rhetoricguitar3aiEngineer/MotoNode/eclipse-lamp/electronics/hub/drc-report.txt

** Drc report for eclipse-hub.kicad_pcb **
** Created on 2026-10-11T15:10:16+0000 **
** Report includes: Errors, Warnings **

** Found 0 DRC violations **

** Found 0 unconnected pads **

** Found 0 Footprint errors **

** End of Report **
