rhetoricguitar3aiEngineer/MotoNode/eclipse-lamp/electronics/core/drc-report.txt

** Drc report for eclipse-core.kicad_pcb **
** Created on 2026-10-10T22:11:24+0000 **
** Report includes: Errors, Warnings **

** Found 0 DRC violations **

** Found 0 unconnected pads **

** Found 0 Footprint errors **

** End of Report **
