rhetoricguitar3aiEngineer/MotoNode/eclipse-lamp/electronics/sprig/drc-report.txt

** Drc report for eclipse-sprig.kicad_pcb **
** Created on 2026-10-10T22:09:48+0000 **
** Report includes: Errors, Warnings **

** Found 0 DRC violations **

** Found 0 unconnected pads **

** Found 0 Footprint errors **

** End of Report **
