rhetoricguitar3aiEngineer/MotoNode/eclipse-lamp/renders/pcb_core_bottom.png

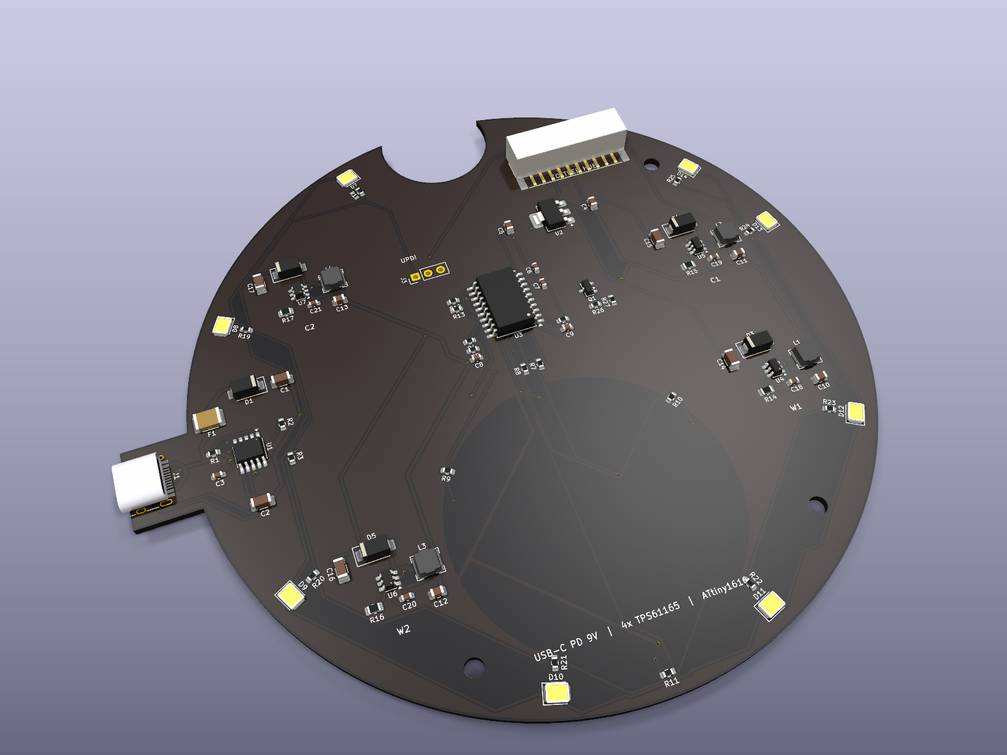
eclipse-lamp/renders/pcb_core_bottom.png
