rhetoricguitar3aiEngineer/MotoNode/eclipse-lamp/renders/pcb_core_top.png

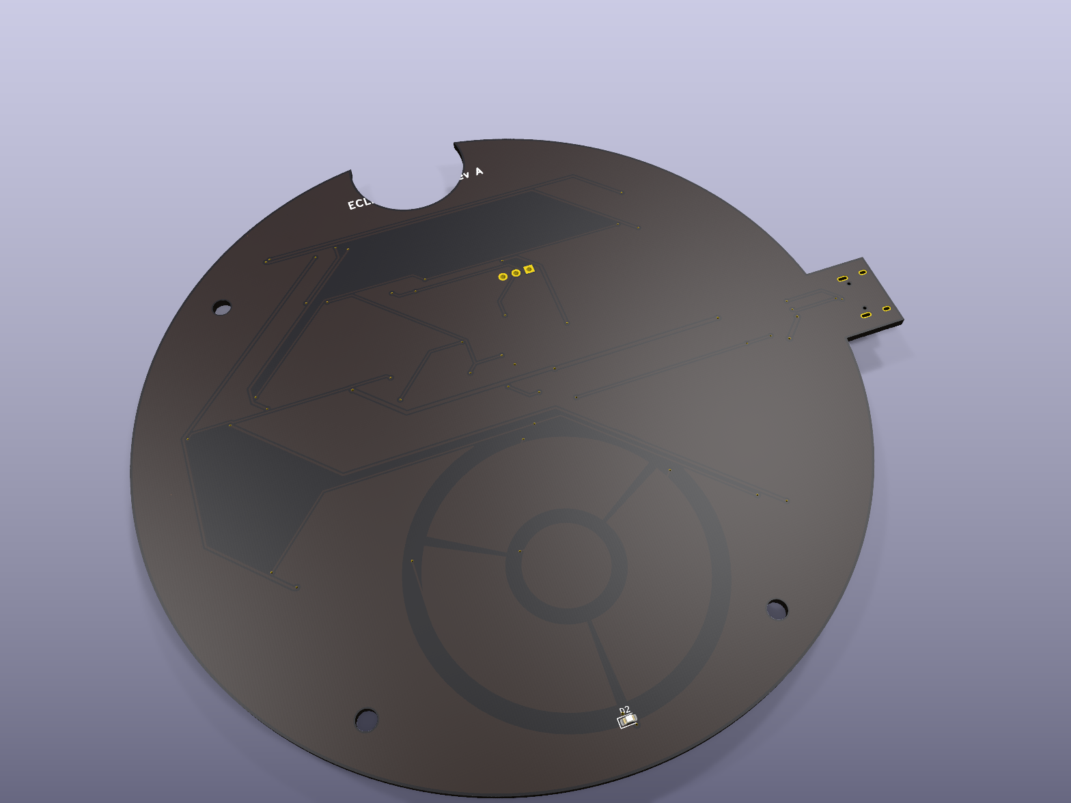
eclipse-lamp/renders/pcb_core_top.png
