rhetoricguitar3aiEngineer/MotoNode/eclipse-lamp/bom/eclipse_bom.csv

Section | Refs | Qty | Value | Description | Manufacturer | MPN | LCSC | Footprint | Unit USD | Ext USD | Note
Core board (base) | C1,C2 | 2 | 22uF 25V | Input bulk | Murata | GRM31CR61E226KE15L |  | C_1206_3216Metric | 0.06 | 0.12
Core board (base) | C3,C7 | 2 | 1uF | CH224K VDD decoupling,MCU decoupling | Murata | GRM188R61E105KA12D |  | C_0603_1608Metric | 0.006 | 0.012
Core board (base) | C4 | 1 | 10uF | LDO input | Samsung | CL21A106KAYNNNE |  | C_0805_2012Metric | 0.02 | 0.02
Core board (base) | C5 | 1 | 22uF | LDO output | Samsung | CL21A226MAQNNNE |  | C_0805_2012Metric | 0.02 | 0.02
Core board (base) | C6,C8,C9 | 3 | 100nF | MCU decoupling | Murata | GRM188R71H104KA93D |  | C_0603_1608Metric | 0.004 | 0.012
Core board (base) | C10,C11,C12,C13 | 4 | 10uF 25V | Boost input | Samsung | CL21A106KAYNNNE |  | C_0805_2012Metric | 0.02 | 0.08
Core board (base) | C14,C15,C16,C17 | 4 | 1uF 50V | Boost output | Murata | GRM31MR71H105KA88L |  | C_1206_3216Metric | 0.04 | 0.16
Core board (base) | C18,C19,C20,C21 | 4 | 220nF | Loop compensation | Murata | GRM188R71E224KA88D |  | C_0603_1608Metric | 0.006 | 0.024
Core board (base) | D1 | 1 | SMAJ15CA | TVS 15 V standoff, bidirectional, 400 W | Littelfuse | SMAJ15CA |  | D_SMA | 0.05 | 0.05
Core board (base) | D2 | 1 | WHITE | 0603 white - glow under touch glass | Lite-On | LTW-C191TS5 |  | LED_0603_1608Metric | 0.03 | 0.03
Core board (base) | D3,D4,D5,D6 | 4 | MBRA160 | Schottky 60 V 1 A | onsemi | MBRA160T3G |  | D_SMA | 0.06 | 0.24
Core board (base) | D7,D8,D9,D10,D11,D12,D13,D14 | 8 | 2700K | 2835 warm white, fires down into the white-lined base cavity | Samsung | LM281B+ 2700K |  | LED_PLCC_2835 | 0.03 | 0.24
Core board (base) | F1 | 1 | 1.5A | PTC resettable fuse 1.5 A hold, 24 V | Bourns | MF-MSMF150/24X-2 |  | Fuse_1812_4532Metric | 0.1 | 0.1
Core board (base) | J1 | 1 | USB-C 16P | USB Type-C receptacle, 16P, SMD + THT shell | Korean Hroparts | TYPE-C-31-M-12 | C165948 | USB_C_Receptacle_HRO_TYPE-C-31-M-12 | 0.12 | 0.12
Core board (base) | J2 | 1 | TO HUB | PH 2.0 mm 10-pin side-entry SMD | JST | S10B-PH-SM4-TB |  | JST_PH_S10B-PH-SM4-TB_1x10-1MP_P2.00mm_Horizontal | 0.25 | 0.25
Core board (base) | J3 | 1 | UPDI | UPDI programming header | - | DNP (pogo pads) |  | PinHeader_1x03_P2.54mm_Vertical | 0.0 | 0.0 | DNP
Core board (base) | L1,L2,L3,L4 | 4 | 10uH | 10 uH shielded, Isat 1.6 A | Bourns | SRN4018-100M |  | L_Bourns-SRN4018 | 0.12 | 0.48
Core board (base) | Q1 | 1 | AO3400A | N-MOSFET 30 V, low-side glow switch | Alpha & Omega | AO3400A |  | SOT-23 | 0.03 | 0.03
Core board (base) | R1,R7,R8,R9,R10 | 5 | 1k | CH224K VDD feed,PTC series resistor | Yageo | RC0603FR-071KL |  | R_0603_1608Metric | 0.002 | 0.01
Core board (base) | R2 | 1 | 6.8k | CFG1: 6.8k = 9 V request | Yageo | RC0603FR-076K8L |  | R_0603_1608Metric | 0.002 | 0.002
Core board (base) | R3,R6 | 2 | 10k | NTC pull-up,PG pull-up | Yageo | RC0603FR-0710KL |  | R_0603_1608Metric | 0.002 | 0.004
Core board (base) | R4,R12,R13,R27 | 4 | 100k | Gate pull-down,Keeps drivers off during reset,VIN sense divider top | Yageo | RC0603FR-07100KL |  | R_0603_1608Metric | 0.002 | 0.008
Core board (base) | R5 | 1 | 15k | VIN sense divider bottom | Yageo | RC0603FR-0715KL |  | R_0603_1608Metric | 0.002 | 0.002
Core board (base) | R11 | 1 | 470 | Status LED | Yageo | RC0603FR-07470RL |  | R_0603_1608Metric | 0.002 | 0.002
Core board (base) | R14,R15,R16,R17 | 4 | 2.0 | Sense: 200 mV / 2.0 R = 100 mA | Yageo | RC0805FR-072RL |  | R_0805_2012Metric | 0.004 | 0.016
Core board (base) | R18,R19,R20,R21,R22,R23,R24,R25,R26 | 9 | 100 | Gate series,Glow LED ballast, ~5 mA | Yageo | RC0603FR-07100RL |  | R_0603_1608Metric | 0.002 | 0.018
Core board (base) | U1 | 1 | CH224K | USB PD/QC sink trigger, resistor-configured output voltage | WCH | CH224K | C970725 | SSOP-10-1EP_3.9x4.9mm_P1mm_EP2.1x3.3mm | 0.35 | 0.35
Core board (base) | U2 | 1 | AMS1117-3.3 | LDO 3.3 V 1 A | Advanced Monolithic Systems | AMS1117-3.3 | C6186 | SOT-223-3_TabPin2 | 0.05 | 0.05
Core board (base) | U3 | 1 | ATtiny1616-S | AVR 16 kB, PTC touch, 20 MHz | Microchip | ATTINY1616-SNR |  | SOIC-20W_7.5x12.8mm_P1.27mm | 0.85 | 0.85
Core board (base) | U4,U5,U6,U7 | 4 | TPS61165 | 38 V boost white-LED driver, 1.2 A switch | Texas Instruments | TPS61165DBVR |  | SOT-23-6 | 0.55 | 2.2
Hub board (in the trunk fork) | D1,D2,D3,D4,D9,D10,D11,D12 | 8 | 2700K | Fibre-bundle light source (top), 25 mA,Trunk light-guide source (bottom), 25 mA | Samsung | LM281B+ 2700K |  | LED_PLCC_2835 | 0.03 | 0.24
Hub board (in the trunk fork) | D5,D6,D7,D8,D13,D14,D15,D16 | 8 | 6500K | Fibre-bundle light source (top), 25 mA,Trunk light-guide source (bottom), 25 mA | Samsung | LM281B+ 6500K |  | LED_PLCC_2835 | 0.03 | 0.24
Hub board (in the trunk fork) | TH1 | 1 | 10k B3380 | NTC 10k 1% B=3380, 0603 | Murata | NCP18XH103F03RB |  | R_0603_1608Metric | 0.03 | 0.03
LED sprigs (x40 per lamp) | D1,D2,D3,D4,D5,D6,D7,D8,D9,D10,D11,D12,D13,D14,D15,D16,D17,D18,D19,D20 on 20 sprigs | 400 | LEAF 2700 K | Leaf LED 0402 white 2700 K, If 5 mA | Inolux / Lite-On (select bin) | 0402 white LED 2700 K (select bin) |  | LED_0402_1005Metric | 0.012 | 4.8 | same Vf bin per sprig
LED sprigs (x40 per lamp) | D1,D2,D3,D4,D5,D6,D7,D8,D9,D10,D11,D12,D13,D14,D15,D16,D17,D18,D19,D20 on 20 sprigs | 400 | LEAF 6500 K | Leaf LED 0402 white 6500 K, If 5 mA | Inolux / Lite-On (select bin) | 0402 white LED 6500 K (select bin) |  | LED_0402_1005Metric | 0.012 | 4.8 | same Vf bin per sprig
Bare PCBs | PCB1 | 1 |  | Core PCB, D124 + USB tab, 2L 1.6 mm FR4, 1 oz, matte black, ENIG | PCB fab (e.g. JLCPCB) | eclipse-core |  |  | 1.2 | 1.2 | gerbers via KiCad
Bare PCBs | PCB2 | 1 |  | Hub light-engine PCB, D56 with D5 hole, 2L 1.0 mm FR4, white mask, ENIG, 2-side SMT | PCB fab (e.g. JLCPCB) | eclipse-hub |  |  | 0.6 | 0.6 | gerbers via KiCad
Bare PCBs | PCB3 | 40 |  | Sprig flex, 2L polyimide 0.11 mm, bronze coverlay, ENIG (panelised) | PCB fab (e.g. JLCPCB) | eclipse-sprig |  |  | 0.22 | 8.8 | gerbers via KiCad
Mechanical | M1 | 1 |  | Base upper shell, D150 x 12 (touch skin + trunk socket) | 6061-T6, CNC turned+milled, bead blast, graphite anodise; cavity white-painted | ECL-M-001 |  |  | 7.5 | 7.5
Mechanical | M2 | 1 |  | Weight / reflector disc, D110 x 6.5 (~0.48 kg) | S235 steel, laser cut, white powder coat | ECL-M-002 |  |  | 1.6 | 1.6
Mechanical | M3 | 1 |  | Root-glow band, D148/D138 x 7 | Light-diffusing PMMA, extruded tube cut + polished | ECL-M-003 |  |  | 0.7 | 0.7
Mechanical | M4 | 1 |  | Plinth, D150 x 3 + 3 posts (~0.42 kg) | S235 steel, laser cut, posts welded, black powder coat | ECL-M-004 |  |  | 2.4 | 2.4
Mechanical | M5 | 1 |  | Foot ring, D146/D122 x 1 | Cork/rubber composite, die cut, PSA backed | ECL-M-005 |  |  | 0.3 | 0.3
Mechanical | M6 | 1 |  | Touch window, D52 x 3 | Soda-lime glass, satin etch top, screen-printed ring | ECL-M-006 |  |  | 1.6 | 1.6
Mechanical | M7 | 1 |  | Trunk shell D77 (root flare, fork swelling that houses the hub), 7 buttress roots, open bark fissures | Lost-wax cast silicon bronze, 2.5 mm wall, 2 halves | ECL-M-007 |  |  | 21.0 | 21.0
Mechanical | M7a | 1 |  | Trunk light-guide tube, ~150 mm, 8 mm wall (harness in the bore) | Light-diffusing PMMA (LED-grade, low haze), cast + polished, white-dot extraction print | ECL-M-016 |  |  | 5.5 | 5.5
Mechanical | M7b | 1 |  | Trunk spigot, D14 x 2 tube, 40 mm (into the base socket) | C260 brass, brazed into the trunk casting | ECL-M-017 |  |  | 0.6 | 0.6
Mechanical | M8 | 1 |  | Leaders + scaffold limbs (wood >= D12): 3 leaders flaring out of the fork, 7 cast pieces | Lost-wax cast silicon bronze, 2 mm wall, brazed to the trunk casting | ECL-M-008 |  |  | 12.0 | 12.0
Mechanical | M9 | 1 |  | Crown wood: 1,167 branches and twigs grown by space colonisation (~29 m), pipe-model taper | 21 x C260 brass tube D4-12 + 1,146 x C260 rod/wire D0.8-4, jig-formed from parts.json, brazed | ECL-M-009 |  |  | 46.0 | 46.0
Mechanical | M9a | 1 |  | End-glow optical fibre, 567 x 0.5 mm, ~0.35 m each, in 4 bundles | PMMA POF, end-glow, black jacket stripped at the tips | ECL-O-001 |  |  | 4.2 | 4.2
Mechanical | M9b | 4 |  | Fibre bundle ferrule (over the hub's top LED pair) | Machined aluminium, polished fibre face, optical gel | ECL-O-002 |  |  | 0.4 | 1.6
Mechanical | M9c | 567 |  | Samara (seed) diffuser, 3.6 x 2.4 x 0.9 mm, dip-moulded on each fibre tip | Diffusing epoxy (TiO2 0.2 %), warm tint | ECL-O-003 |  |  | 0.003 | 1.701
Mechanical | M9d | 1 |  | Foliage: 21,770 cedar-elm leaves (4.6-7 mm) as ~1,170 laser-cut twig sprays | 0.125 mm light-diffusing olive PET film, 2 tones, bonded to the twigs | ECL-O-004 |  |  | 9.0 | 9.0
Mechanical | M10 | 1 |  | Bark finish, whole tree | Brown-grey liver-of-sulphur patina + matte lacquer | ECL-M-010 |  |  | 2.5 | 2.5
Mechanical | M11 | 1 |  | Magnet wire, 80 x 0.15 mm, ~0.4 m each, laid along the wood | Polyurethane-enamelled Cu (solderable), bark-colour | ECL-W-002 |  |  | 0.7 | 0.7
Mechanical | M12 | 1 |  | Trunk harness, 10 x AWG30 PTFE, 260 mm | Hub J1 lands -> core J2 (JST PHR-10 + SPH-002T) | ECL-W-001 |  |  | 0.7 | 0.7
Mechanical | M13 | 1 |  | Hub potting + light-engine optical gel | Black flexible epoxy (back side) + clear silicone gel (LED faces) | ECL-M-013 |  |  | 0.4 | 0.4
Mechanical | F1 | 3 |  | Screw M3 x 6, pan head (core PCB) | A2 stainless | ISO 14583 |  |  | 0.02 | 0.06
Mechanical | F2 | 1 |  | Set screw M4 x 4, cup point (trunk socket) | A2 stainless | ISO 4029 |  |  | 0.02 | 0.02
Mechanical | F3 | 3 |  | Screw M3 x 10, countersunk (plinth posts into shell) | A2 stainless | ISO 10642 |  |  | 0.03 | 0.09
Mechanical | F4 | 2 |  | Screw M2 x 6 (trunk casting halves at the fork) | A2 stainless | ISO 14583 |  |  | 0.02 | 0.04
Mechanical | F5 | 40 |  | Sprig clip: 0.3 mm brass crimp sleeve, sprig root grafted onto its branchlet | C260 brass | ECL-M-014 |  |  | 0.01 | 0.4
