rhetoricguitar3aiEngineer/MotoNode/eclipse-lamp/electronics/core/eclipse-core.step

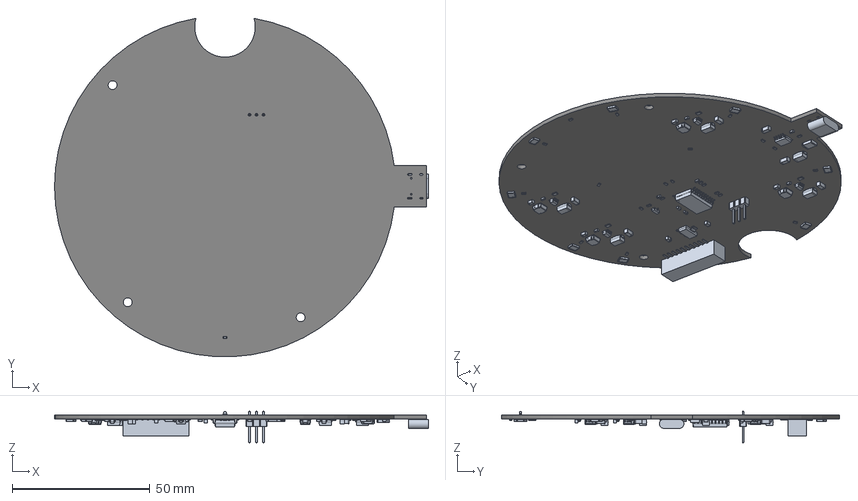
[picture p12: CAD file, 2026-10-11]
eclipse-lamp/electronics/core/eclipse-core.step
136.0 x 123.0 x 11.5 mm
LED_0603_1608Metric
R_0603_1608Metric x 23
housing x 9
phosphor x 8
R_0805_2012Metric x 4
C_1206_3216Metric x 6
L_Bourns-SRN4018 x 4
C_0805_2012Metric x 6
SOT-23-6 x 4
tongue
C_0603_1608Metric x 9
term-1
term1
D_SMA x 5
SOT-23
SOT-223
SSOP-10-1EP_3.9x4.9mm_P1mm_EP2.1x3.3mm
PinHeader_1x03_P2.54mm_Vertical
pins
SOIC-20W_7.5x12.8mm_P1.27mm
eclipse-core_PCB
