rhetoricguitar3aiEngineer/MotoNode/eclipse-lamp/electronics/hub/eclipse-hub.step

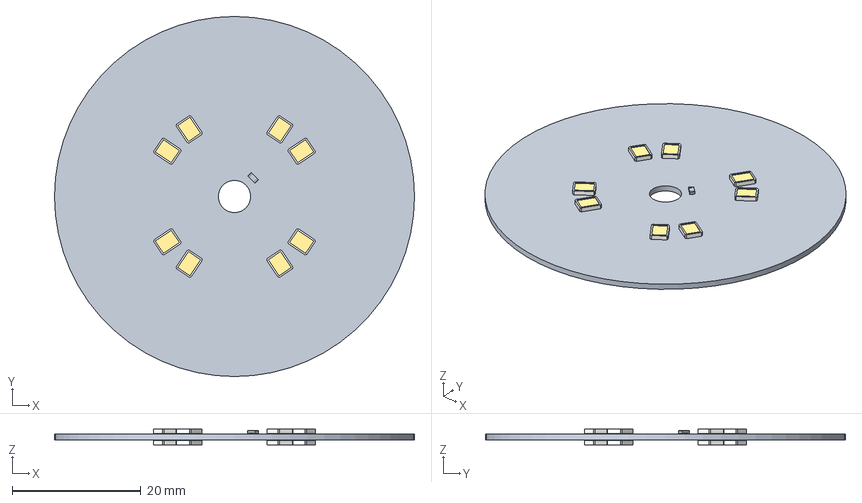
[picture p13: CAD file, 2026-10-11]
eclipse-lamp/electronics/hub/eclipse-hub.step
56.0 x 56.0 x 2.48 mm
housing x 16
phosphor x 16
R_0603_1608Metric
eclipse-hub_PCB
