rhetoricguitar3aiEngineer/MotoNode/eclipse-lamp/electronics/sprig/eclipse-sprig.step

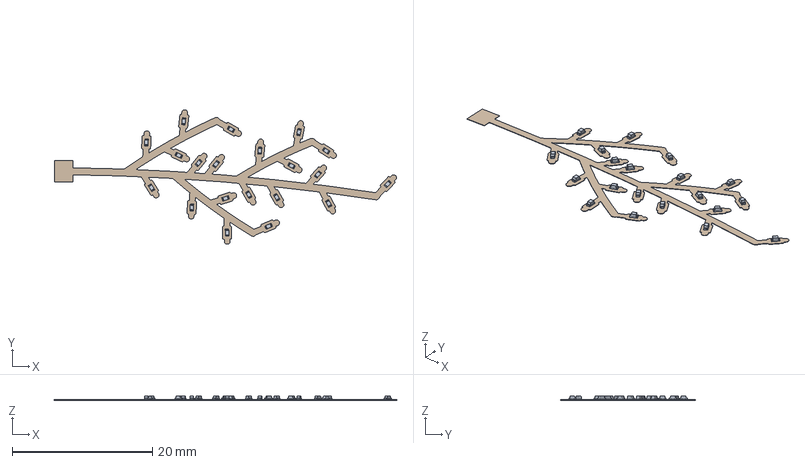
[picture p14: CAD file, 2026-10-11]
eclipse-lamp/electronics/sprig/eclipse-sprig.step
48.8 x 19.2 x 0.622 mm
LED_0402_1005Metric x 20
eclipse-sprig_PCB
