rhetoricguitar3aiEngineer/MotoNode/eclipse-lamp/mechanical/out/base_foot.step

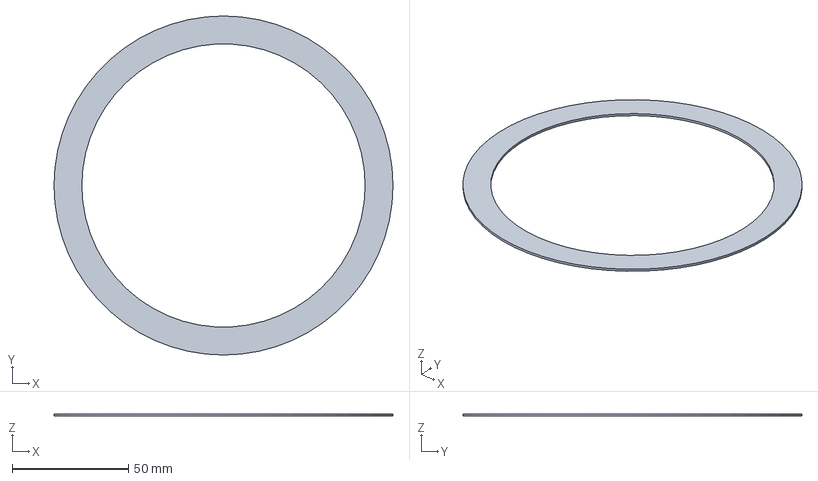
[picture p15: CAD file, 2026-10-16]
eclipse-lamp/mechanical/out/base_foot.step
146.0 x 146.0 x 1.00 mm
