rhetoricguitar3aiEngineer/MotoNode/eclipse-lamp/mechanical/out/base_shell.step

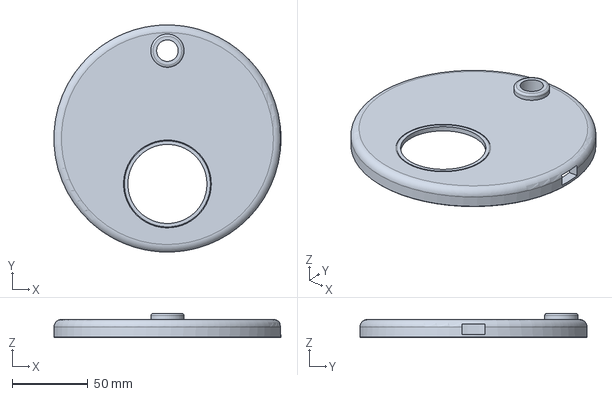
[picture p16: CAD file, 2026-10-16]
eclipse-lamp/mechanical/out/base_shell.step
149.9 x 149.9 x 16.0 mm
