rhetoricguitar3aiEngineer/MotoNode/eclipse-lamp/mechanical/out/trunk.step

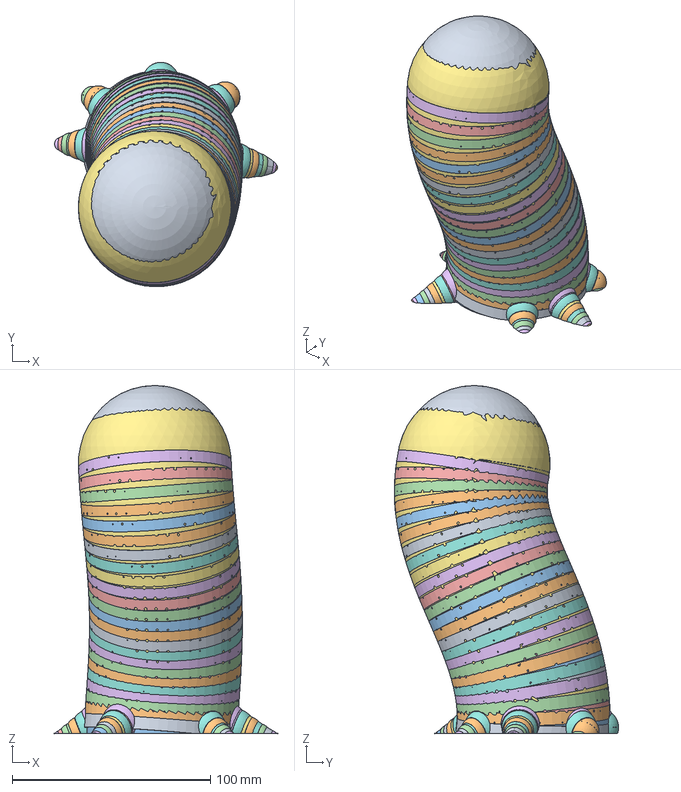
[picture p17: CAD file, 2026-10-16]
eclipse-lamp/mechanical/out/trunk.step
112.4 x 113.0 x 175.3 mm
