rhetoricguitar3aiEngineer/MotoNode/eclipse-lamp/mechanical/out/touch_etch.step

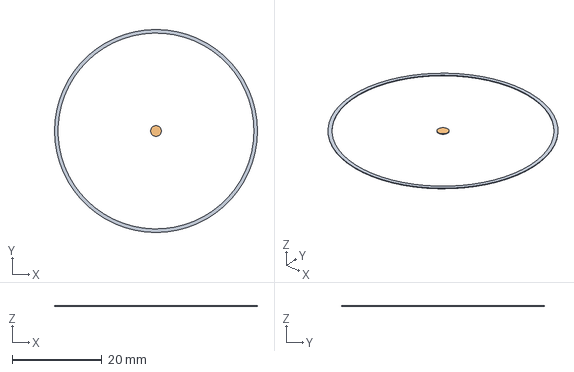
[picture p18: CAD file, 2026-10-16]
eclipse-lamp/mechanical/out/touch_etch.step
45.2 x 45.2 x 0.14 mm
