rhetoricguitar3aiEngineer/MotoNode/eclipse-lamp/mechanical/out/trunk_core.step

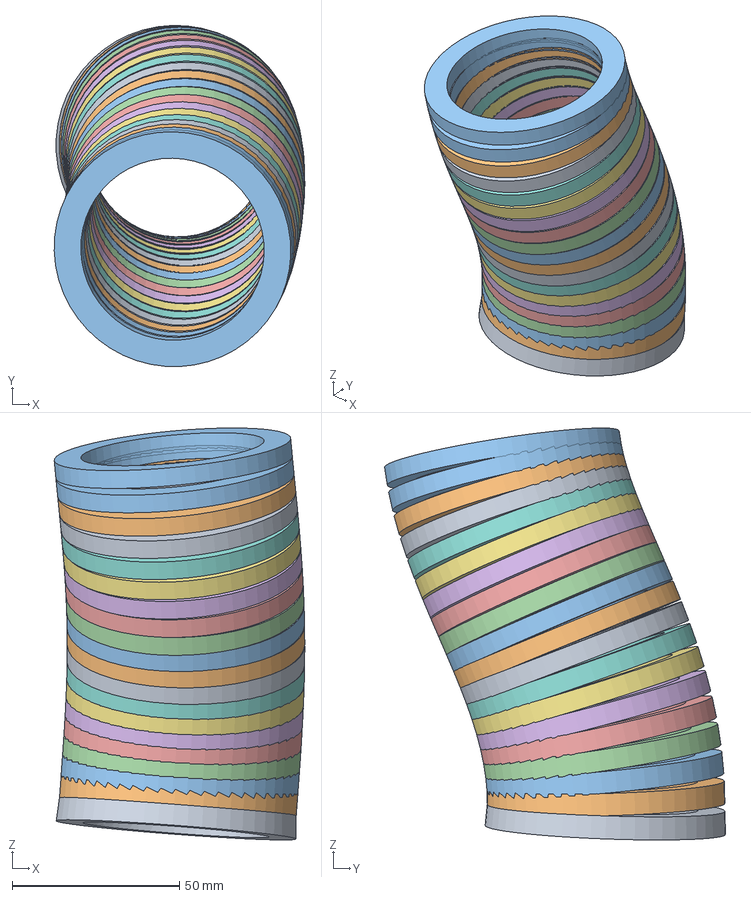
[picture p19: CAD file, 2026-10-16]
eclipse-lamp/mechanical/out/trunk_core.step
75.0 x 102.0 x 123.2 mm
