rhetoricguitar3aiEngineer/MotoNode/eclipse-lamp/mechanical/out/base_weight.step

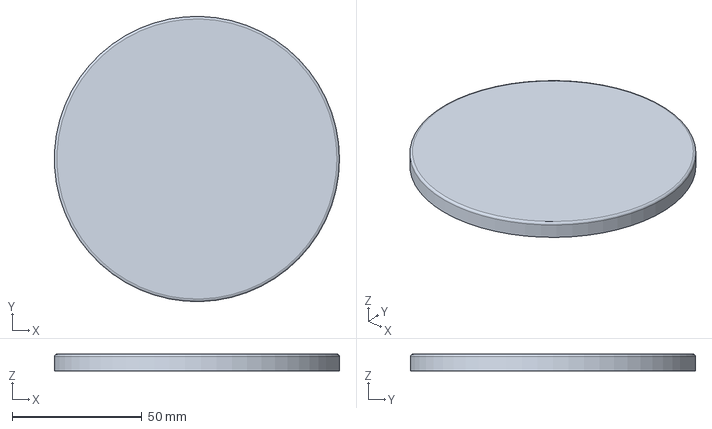
[picture p20: CAD file, 2026-10-16]
eclipse-lamp/mechanical/out/base_weight.step
109.9 x 110.0 x 6.50 mm
