rhetoricguitar3aiEngineer/MotoNode/eclipse-lamp/mechanical/out/base_plinth.step

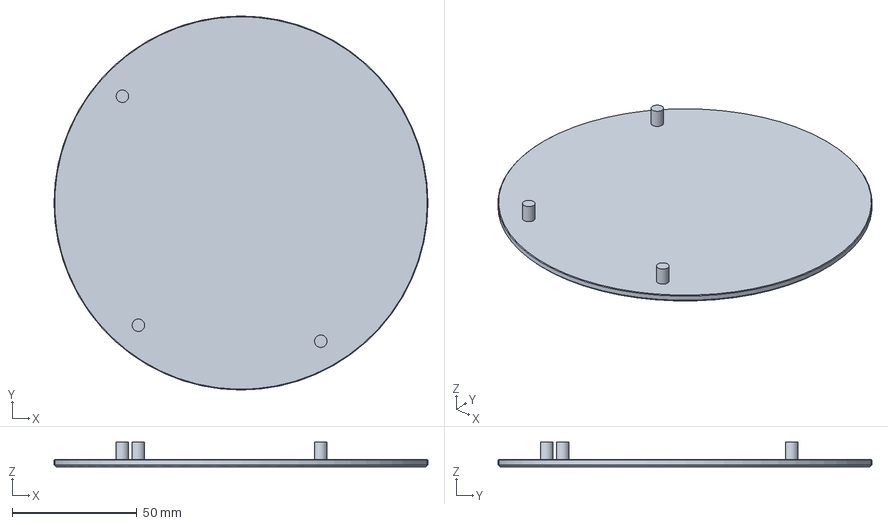
[picture p21: CAD file, 2026-10-16]
eclipse-lamp/mechanical/out/base_plinth.step
150.0 x 150.0 x 10.0 mm
