rhetoricguitar3aiEngineer/MotoNode/eclipse-lamp/mechanical/out/base_band.step

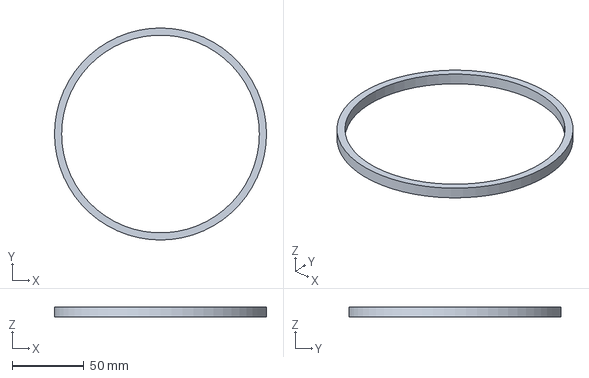
[picture p22: CAD file, 2026-10-16]
eclipse-lamp/mechanical/out/base_band.step
148.0 x 148.0 x 7.00 mm
