rhetoricguitar3aiEngineer/MotoNode/eclipse-lamp/mechanical/out/touch_glass.step

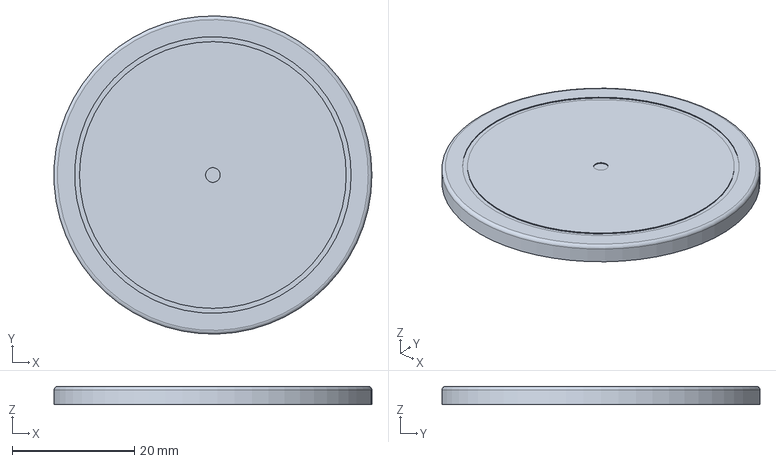
[picture p23: CAD file, 2026-10-16]
eclipse-lamp/mechanical/out/touch_glass.step
52.0 x 52.0 x 3.00 mm
