rhetoricguitar3aiEngineer/MotoNode/eclipse-lamp/mechanical/out/pcb_hub.stl

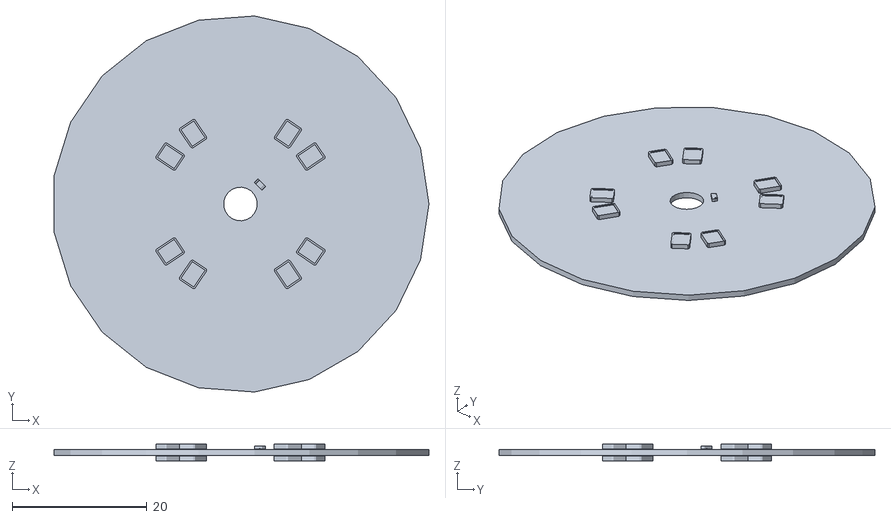
[picture p24: CAD file, 2026-10-16]
eclipse-lamp/mechanical/out/pcb_hub.stl
55.7 x 55.8 x 2.48
