rhetoricguitar3aiEngineer/MotoNode/eclipse-lamp/mechanical/out/foliage.stl

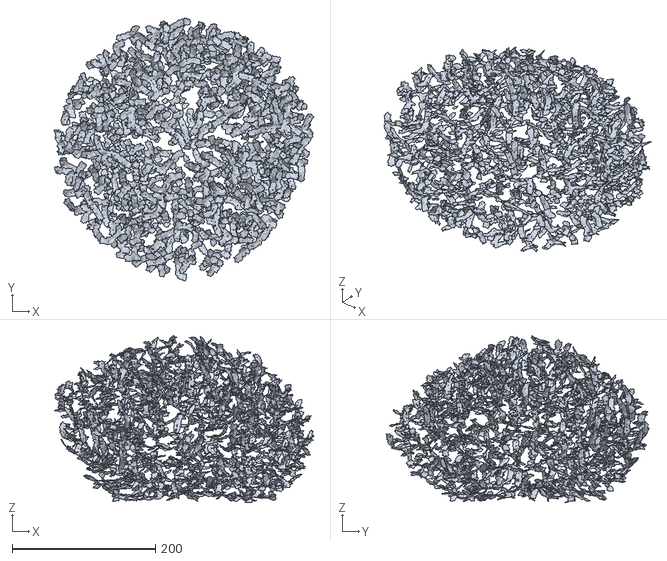
[picture p25: CAD file, 2026-10-16]
eclipse-lamp/mechanical/out/foliage.stl
363.0 x 367.3 x 233.6
