rhetoricguitar3aiEngineer/MotoNode/eclipse-lamp/mechanical/out/burl.step

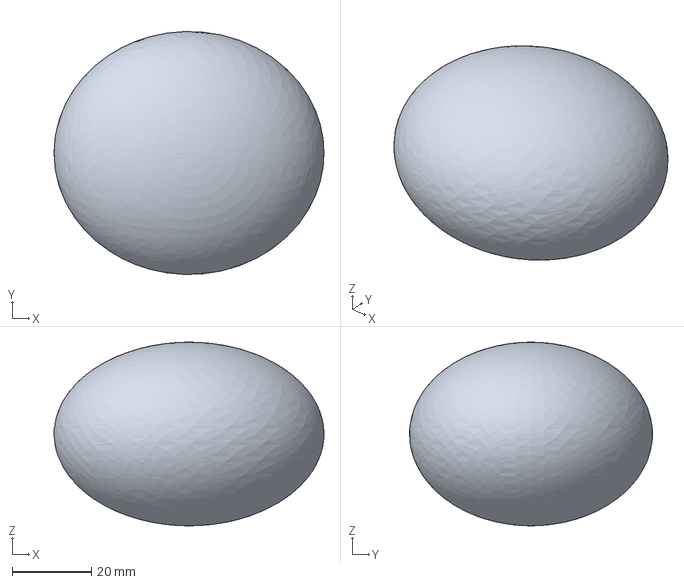
[picture p26: CAD file, 2026-10-11]
eclipse-lamp/mechanical/out/burl.step
68.0 x 61.2 x 46.2 mm
