rhetoricguitar3aiEngineer/MotoNode/eclipse-lamp/mechanical/out/branches.stl

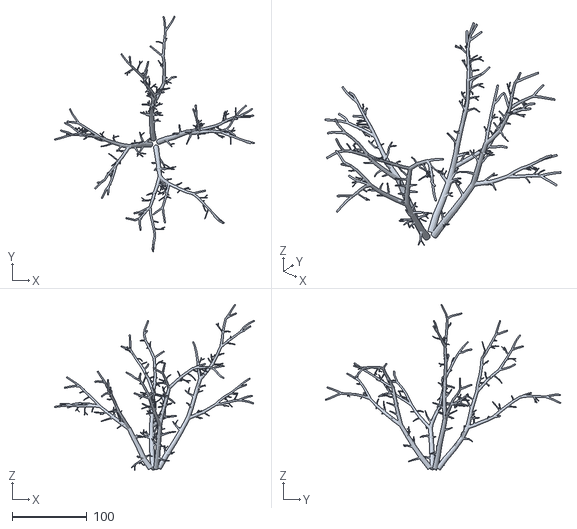
[picture p27: CAD file, 2026-10-10]
eclipse-lamp/mechanical/out/branches.stl
266.9 x 314.3 x 222.1
