rhetoricguitar3aiEngineer/MotoNode/(list of files, cad)

Other CAD files:
eclipse-lamp/mechanical/out/pcb_core.stl
eclipse-lamp/mechanical/out/base_band.stl
eclipse-lamp/mechanical/out/base_foot.stl
eclipse-lamp/mechanical/out/base_plinth.stl
eclipse-lamp/mechanical/out/base_shell.stl
eclipse-lamp/mechanical/out/base_weight.stl
eclipse-lamp/mechanical/out/burl.stl
eclipse-lamp/mechanical/out/touch_etch.stl
eclipse-lamp/mechanical/out/touch_glass.stl
eclipse-lamp/mechanical/out/trunk.stl
eclipse-lamp/mechanical/out/trunk_core.stl
