rhetoricguitar3aiEngineer/MotoNode/eclipse-lamp/docs/WIRING.md

# ECLIPSE Tree - sprig wiring map

Generated by `mechanical/wiring_map.py` from the seeded tree (`tree_gen.SEED`).
Each sprig is grafted onto a branchlet about 44 mm behind a twig tip (graft point listed).
Its magnet-wire pair (A = red enamel, K = clear) runs back along the wood to the
hub land pair at the listed slot (slot 0 = rear, clockwise seen from above).
Azimuth is measured around the hub (in the trunk's fork swelling).

| Sprig | Channel | Chain pos | Leader | Graft azimuth | Graft height | Hub slot | Slot angle |
|---|---|---:|---:|---:|---:|---:|---:|
| C1.01 | C1 | 1 | 1 | 189° | 242 mm | 12 |  98.2° |
| C1.02 | C1 | 2 | 1 | 205° | 342 mm | 13 | 106.4° |
| C1.03 | C1 | 3 | 1 | 235° | 344 mm | 14 | 114.5° |
| C1.04 | C1 | 4 | 1 | 264° | 249 mm | 15 | 122.7° |
| C1.05 | C1 | 5 | 2 | 303° | 234 mm | 16 | 130.9° |
| C1.06 | C1 | 6 | 2 | 343° | 323 mm | 17 | 139.1° |
| C1.07 | C1 | 7 | 2 | 30° | 352 mm | 18 | 147.3° |
| C1.08 | C1 | 8 | 3 | 82° | 340 mm | 19 | 155.5° |
| C1.09 | C1 | 9 | 3 | 108° | 231 mm | 20 | 163.6° |
| C1.10 | C1 | 10 | 3 | 150° | 226 mm | 21 | 171.8° |
| C2.01 | C2 | 1 | 1 | 200° | 345 mm | 34 | 278.2° |
| C2.02 | C2 | 2 | 1 | 216° | 365 mm | 35 | 286.4° |
| C2.03 | C2 | 3 | 1 | 251° | 284 mm | 36 | 294.5° |
| C2.04 | C2 | 4 | 2 | 298° | 271 mm | 37 | 302.7° |
| C2.05 | C2 | 5 | 2 | 335° | 338 mm | 38 | 310.9° |
| C2.06 | C2 | 6 | 2 | 2° | 212 mm | 39 | 319.1° |
| C2.07 | C2 | 7 | 3 | 67° | 231 mm | 40 | 327.3° |
| C2.08 | C2 | 8 | 3 | 89° | 263 mm | 41 | 335.5° |
| C2.09 | C2 | 9 | 3 | 128° | 299 mm | 42 | 343.6° |
| C2.10 | C2 | 10 | 3 | 161° | 319 mm | 43 | 351.8° |
| W1.01 | W1 | 1 | 1 | 181° | 306 mm | 1 | 8.2° |
| W1.02 | W1 | 2 | 1 | 201° | 252 mm | 2 |  16.4° |
| W1.03 | W1 | 3 | 1 | 230° | 296 mm | 3 |  24.5° |
| W1.04 | W1 | 4 | 1 | 258° | 336 mm | 4 |  32.7° |
| W1.05 | W1 | 5 | 2 | 299° | 343 mm | 5 |  40.9° |
| W1.06 | W1 | 6 | 2 | 337° | 216 mm | 6 |  49.1° |
| W1.07 | W1 | 7 | 2 | 19° | 404 mm | 7 |  57.3° |
| W1.08 | W1 | 8 | 3 | 80° | 225 mm | 8 |  65.5° |
| W1.09 | W1 | 9 | 3 | 103° | 312 mm | 9 |  73.6° |
| W1.10 | W1 | 10 | 3 | 134° | 261 mm | 10 |  81.8° |
| W2.01 | W2 | 1 | 1 | 190° | 336 mm | 23 | 188.2° |
| W2.02 | W2 | 2 | 1 | 213° | 266 mm | 24 | 196.4° |
| W2.03 | W2 | 3 | 1 | 241° | 235 mm | 25 | 204.5° |
| W2.04 | W2 | 4 | 1 | 274° | 296 mm | 26 | 212.7° |
| W2.05 | W2 | 5 | 2 | 332° | 267 mm | 27 | 220.9° |
| W2.06 | W2 | 6 | 2 | 345° | 294 mm | 28 | 229.1° |
| W2.07 | W2 | 7 | 2 | 40° | 295 mm | 29 | 237.3° |
| W2.08 | W2 | 8 | 3 | 83° | 352 mm | 30 | 245.5° |
| W2.09 | W2 | 9 | 3 | 119° | 374 mm | 31 | 253.6° |
| W2.10 | W2 | 10 | 3 | 155° | 265 mm | 32 | 261.8° |

Hub ref S1-S40 = channel order W1, C1, W2, C2, ten each, in chain order.
