rhetoricguitar3aiEngineer/MotoNode/eclipse-lamp/electronics/core/fab/eclipse-core-schematic.pdf

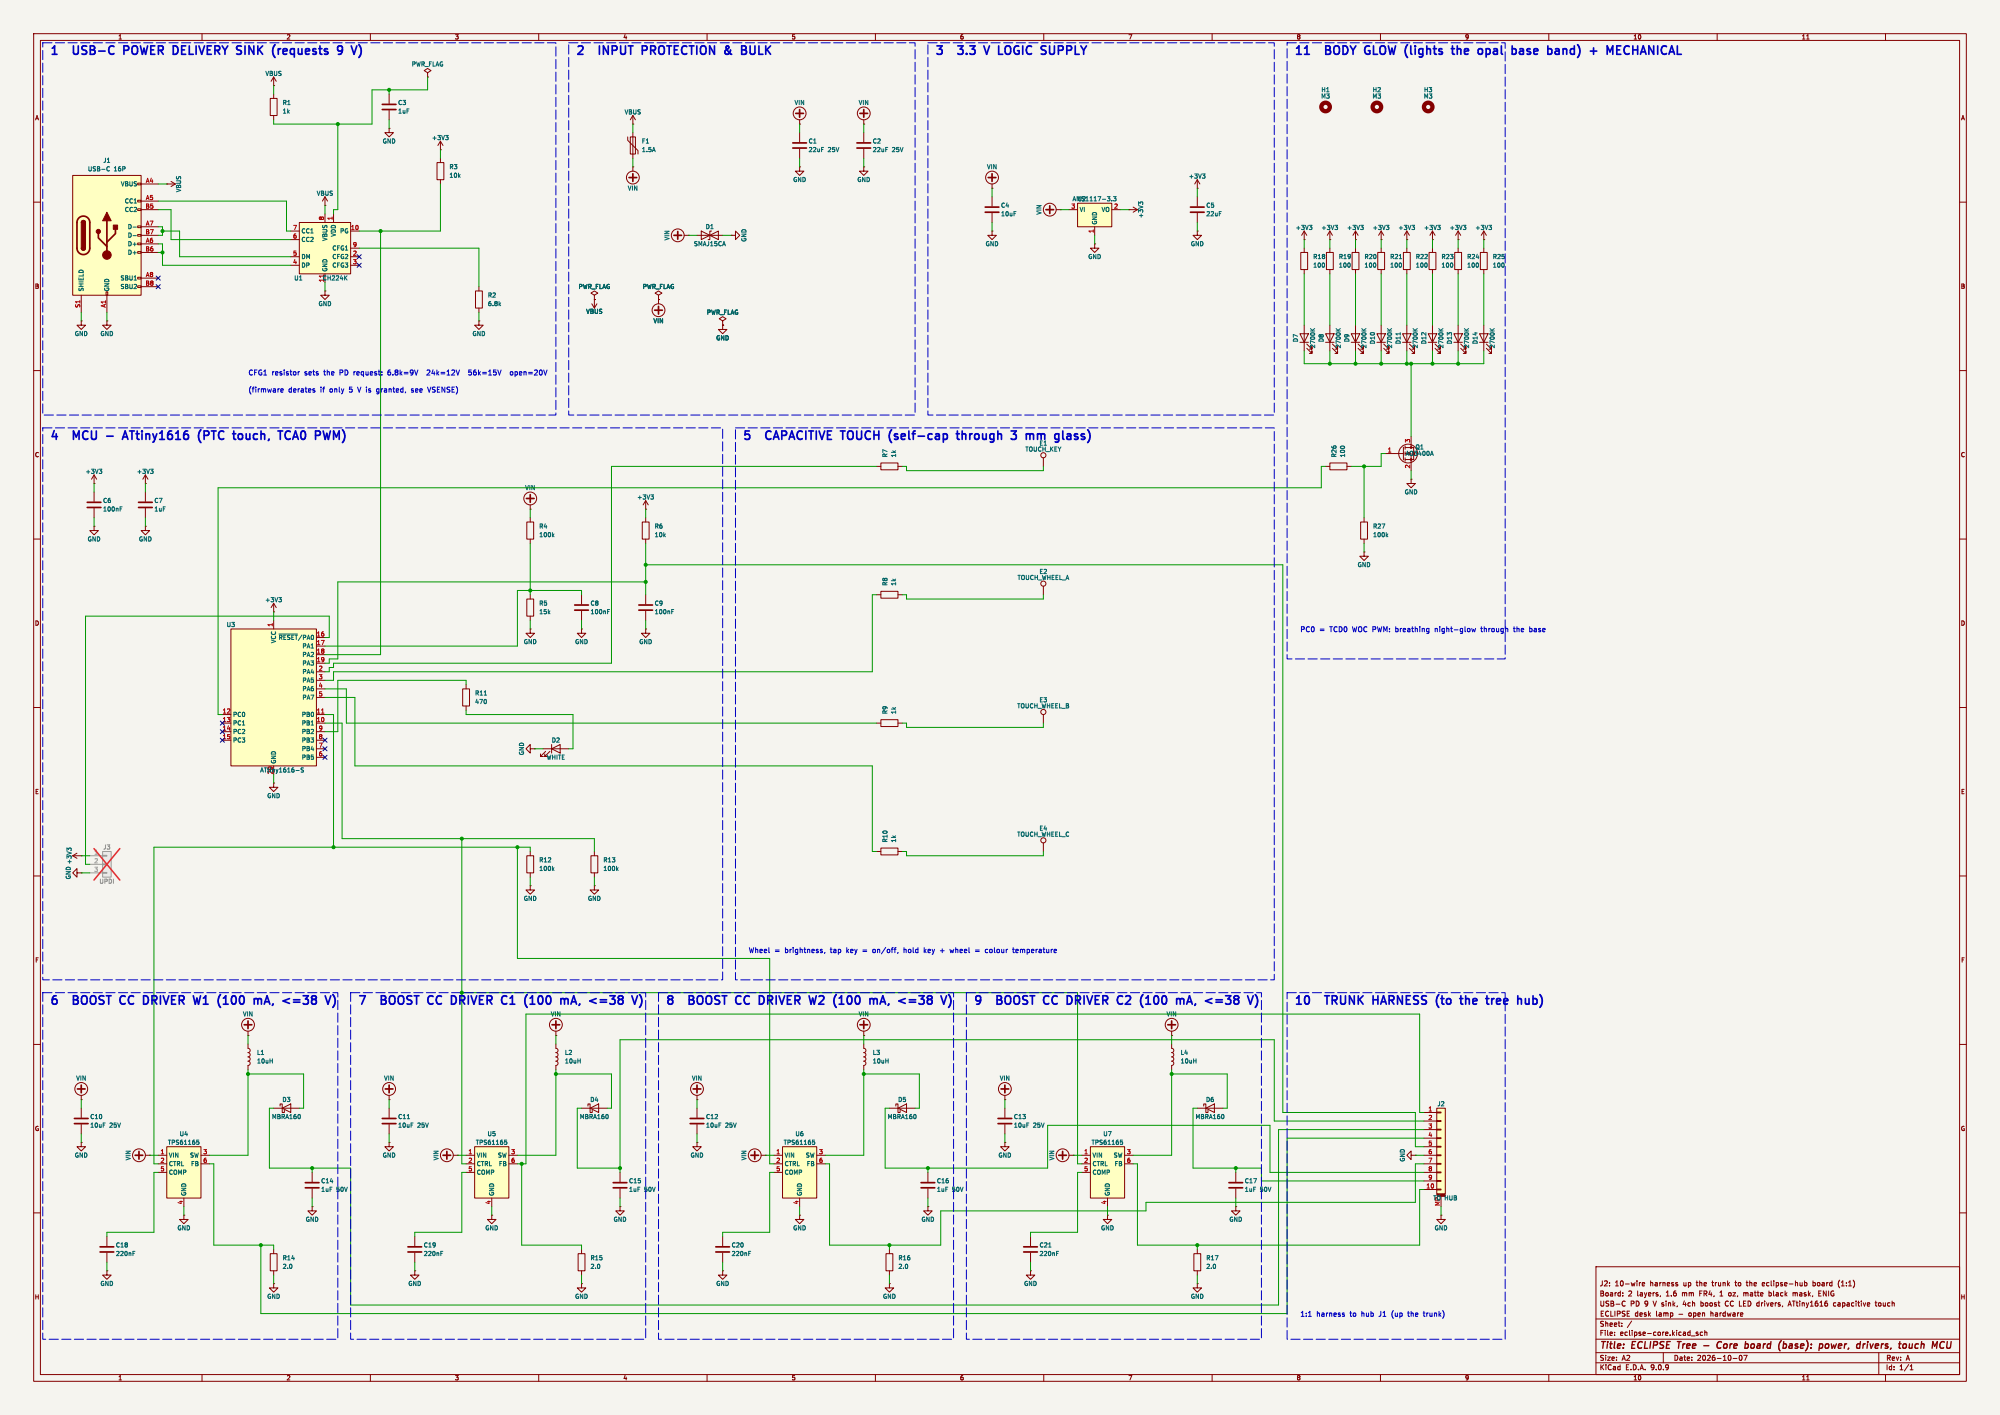
[picture p28: page 1]

4 SW 3 FB 6 U6 TPS61165 GND VIN GND

3 2 Q1 AO3400A CFG1 resistor sets the PD request: 6.8k=9V 24k=12V 56k=15V open=20V

4 SW 3 FB 6 U4 TPS61165 VIN 1 CTRL 2 COMP 5 GND

1:1 harness to hub J1 (up the trunk)
