rhetoricguitar3aiEngineer/MotoNode/eclipse-lamp/electronics/sprig/fab/eclipse-sprig-schematic.pdf

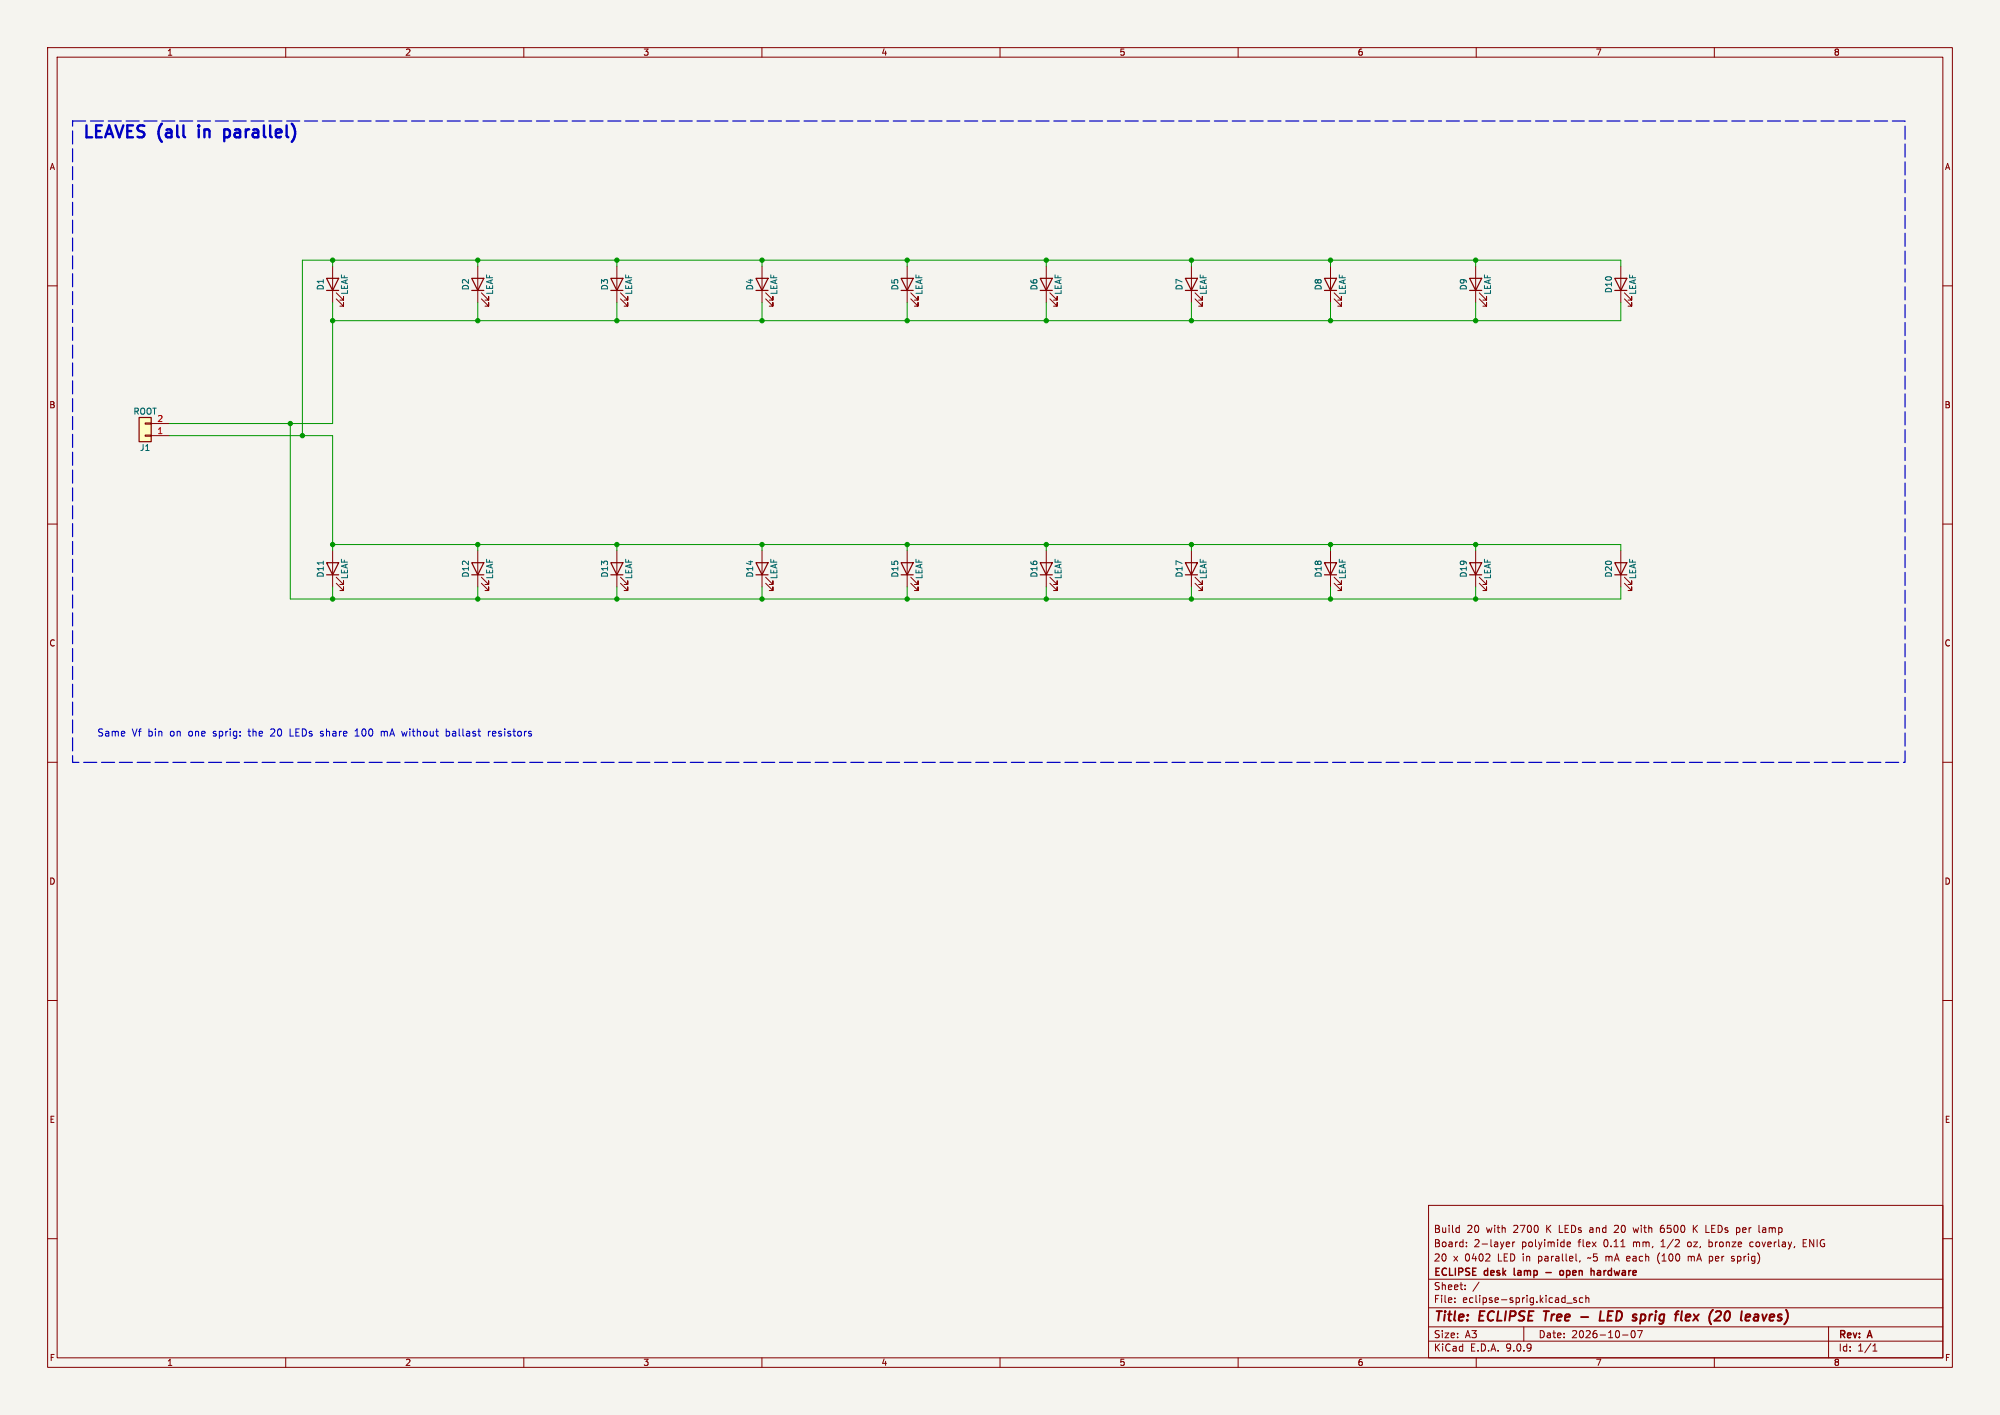
[picture p29: page 1]

20 x 0402 | 2-layer LED in | polyimide parallel, | flex 0.11 ~5 mA each (100 mA | mm, | 1/2 oz, | bronze coverlay, per sprig) Board: | ENIG

open hardware Id: 1/1 Title: ECLIPSE Tree - LED sprig flex (20 leaves) File: eclipse-sprig.kicad_sch Sheet: / ECLIPSE desk lamp -
