rhetoricguitar3aiEngineer/MotoNode/eclipse-lamp/electronics/hub/fab/eclipse-hub-schematic.pdf

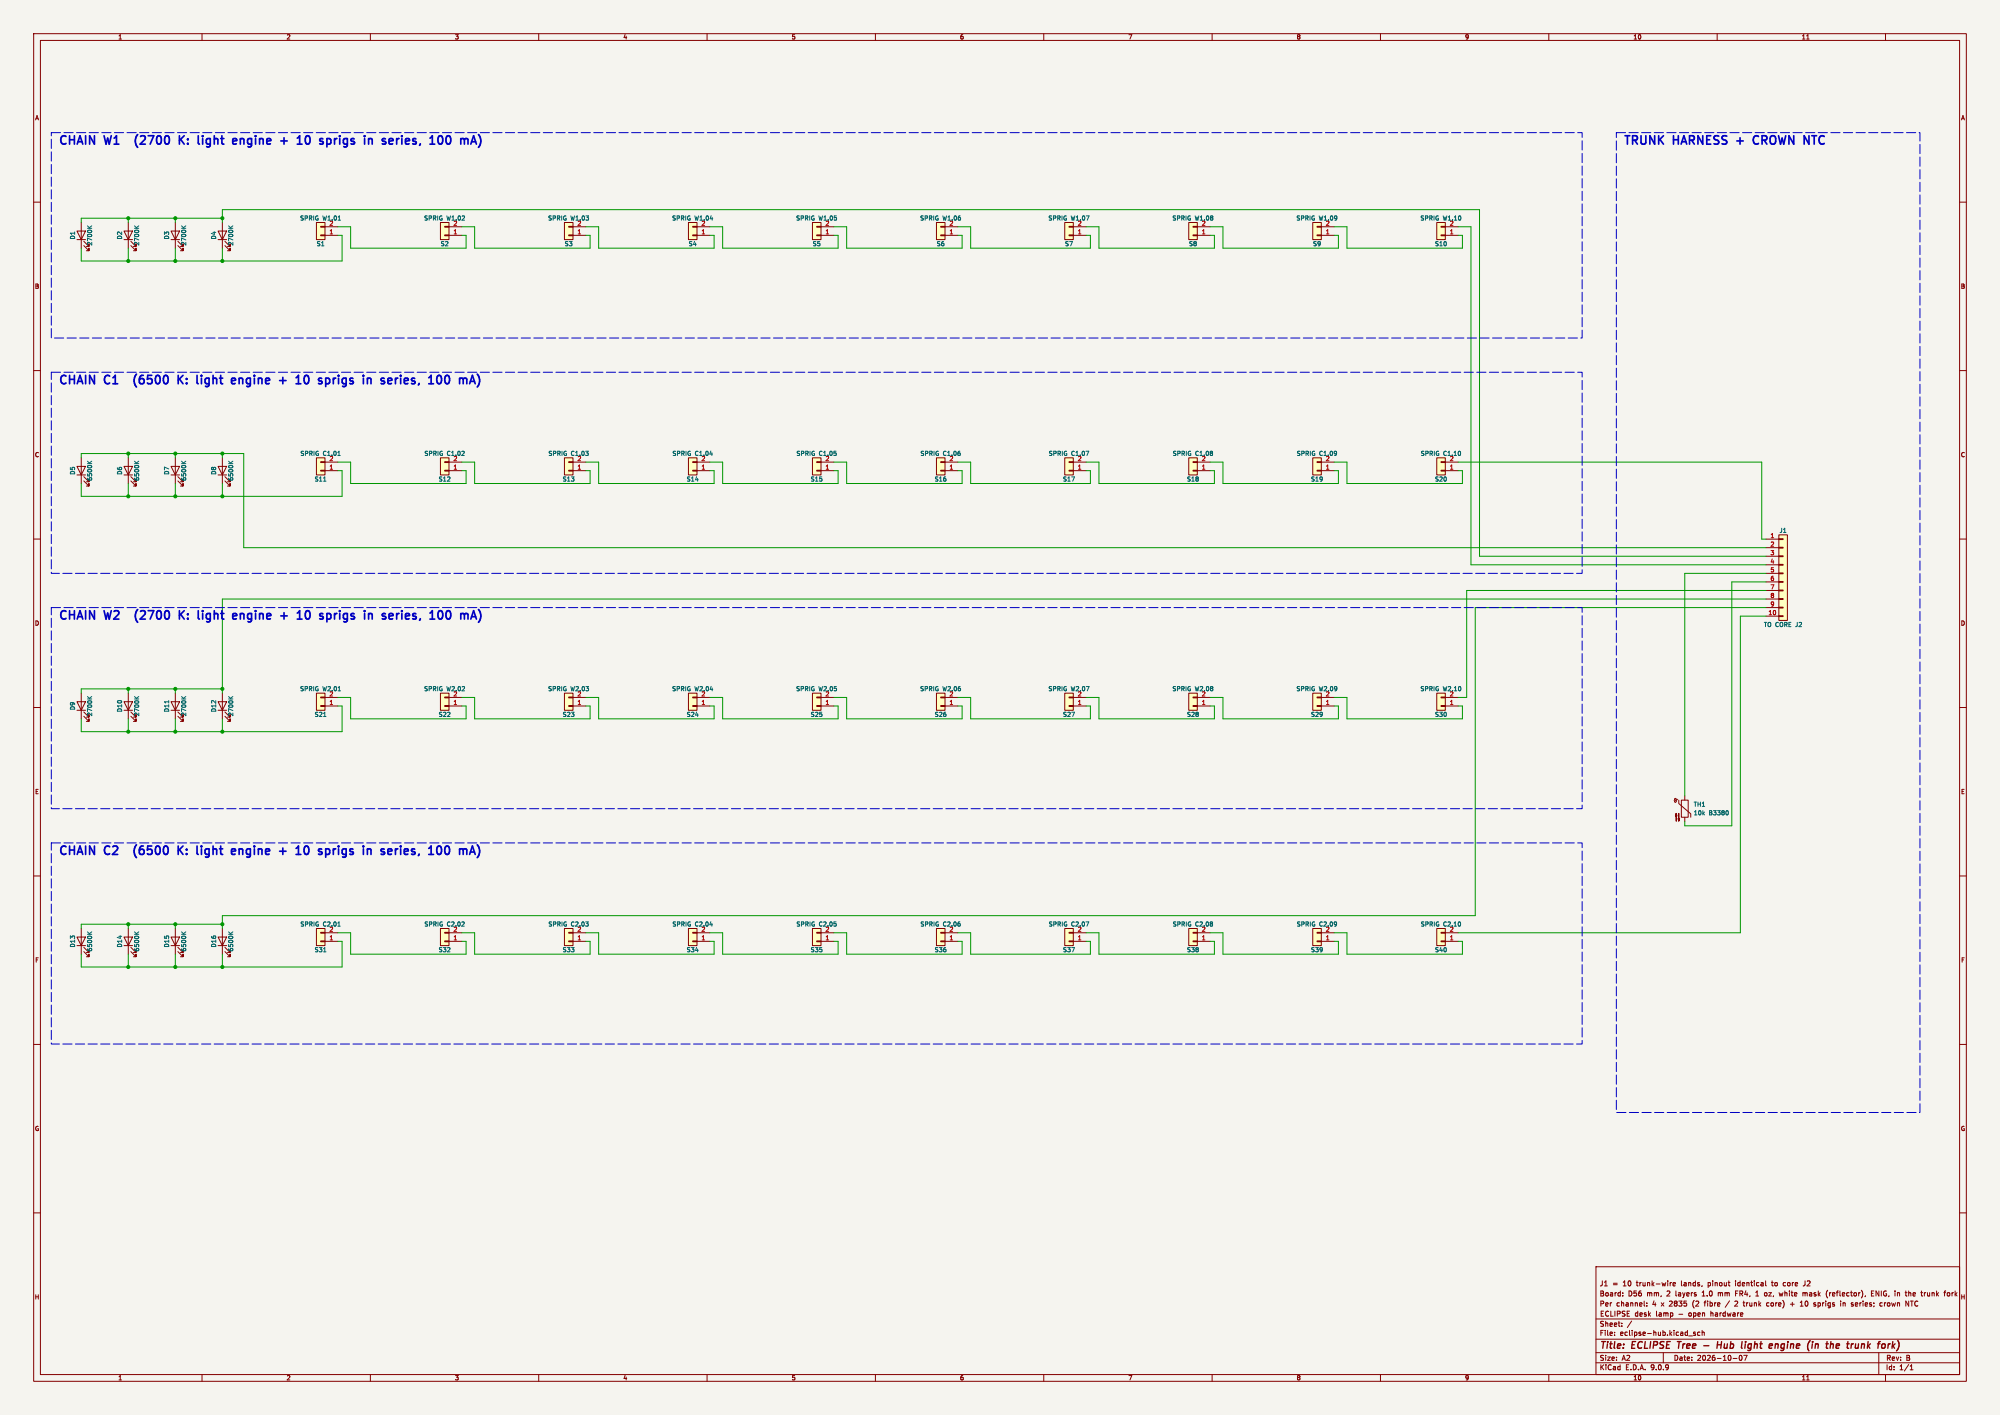
[picture p30: page 1]

TRUNK HARNESS + CROWN NTC
