rhetoricguitar3aiEngineer/MotoNode/eclipse-lamp/electronics/core/fab/eclipse-core-layout.pdf/eclipse-core-B_Cu.pdf

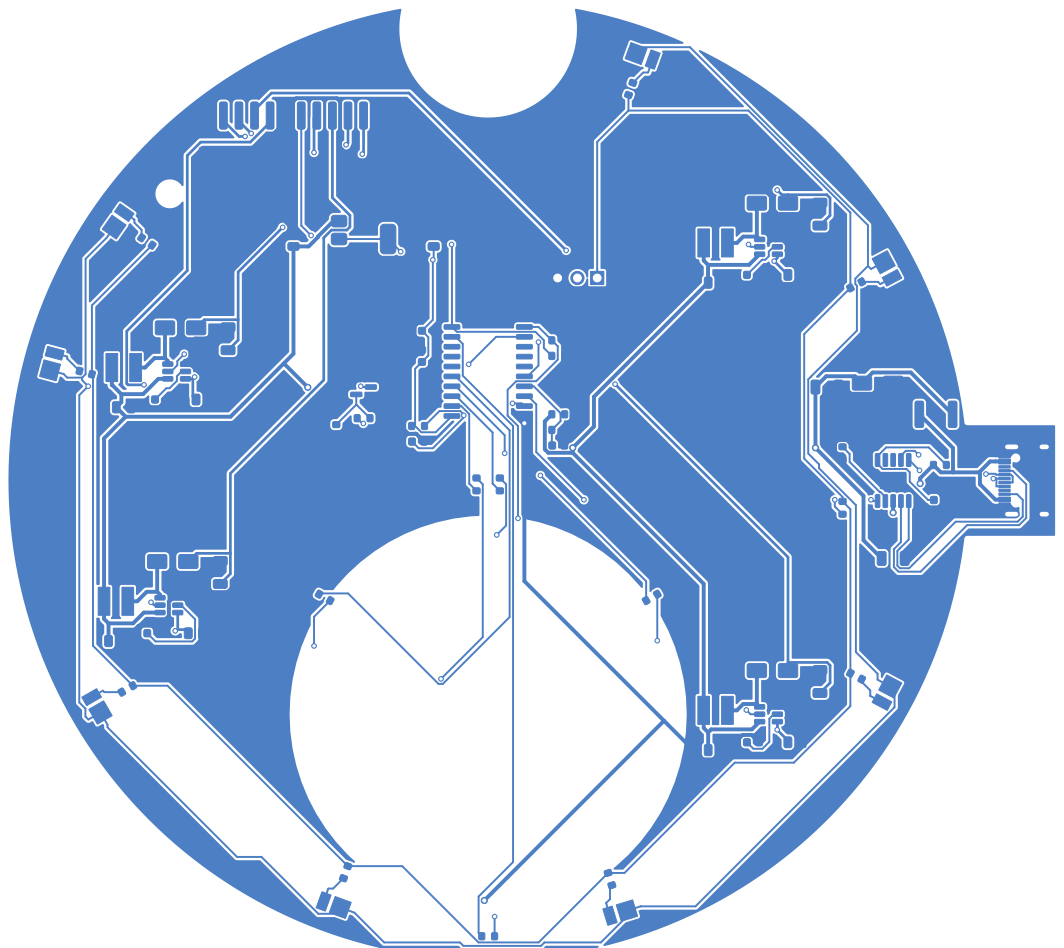
[picture p31: page 1]
