rhetoricguitar3aiEngineer/MotoNode/eclipse-lamp/electronics/core/fab/eclipse-core-layout.pdf/eclipse-core-B_Silkscreen.pdf

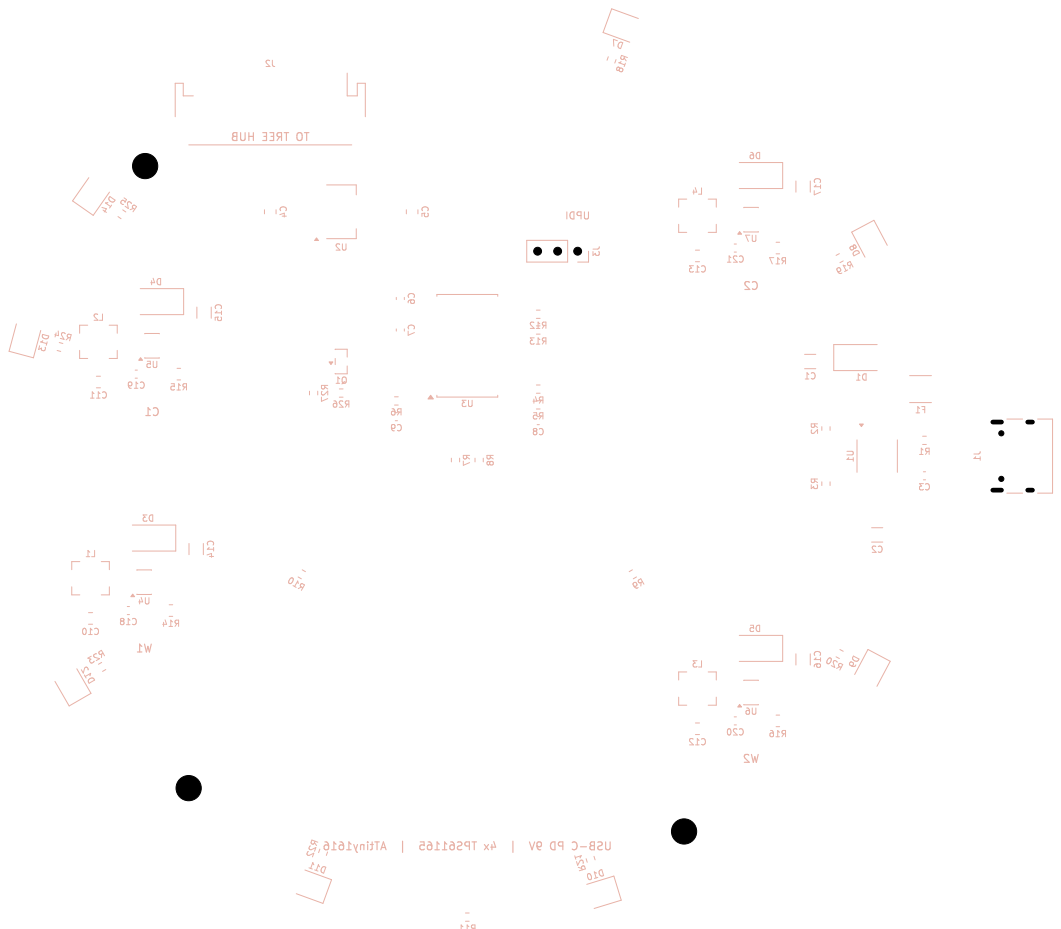
[picture p32: page 1]

UPDI W1 C1 HUB TREE TO
