rhetoricguitar3aiEngineer/MotoNode/eclipse-lamp/electronics/core/fab/eclipse-core-layout.pdf/eclipse-core-Edge_Cuts.pdf

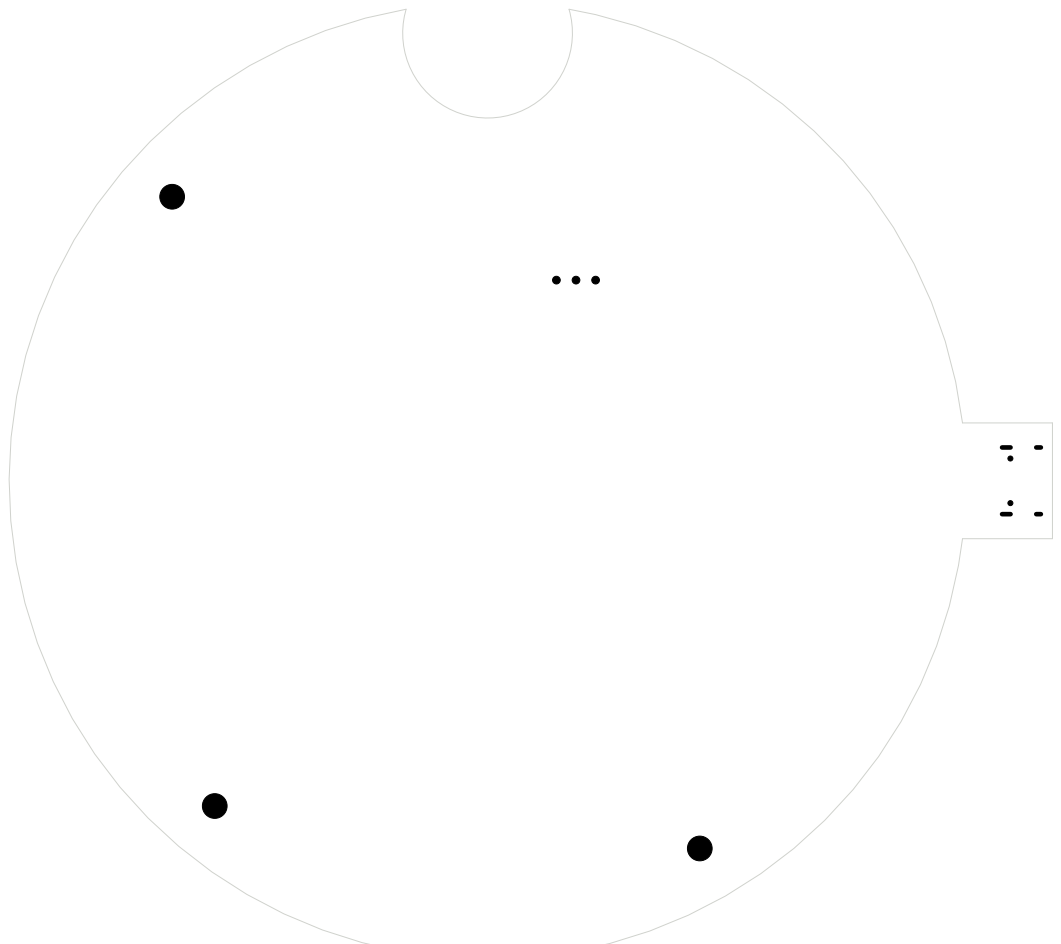
[picture p33: page 1]
