rhetoricguitar3aiEngineer/MotoNode/eclipse-lamp/electronics/core/fab/eclipse-core-layout.pdf/eclipse-core-F_Cu.pdf

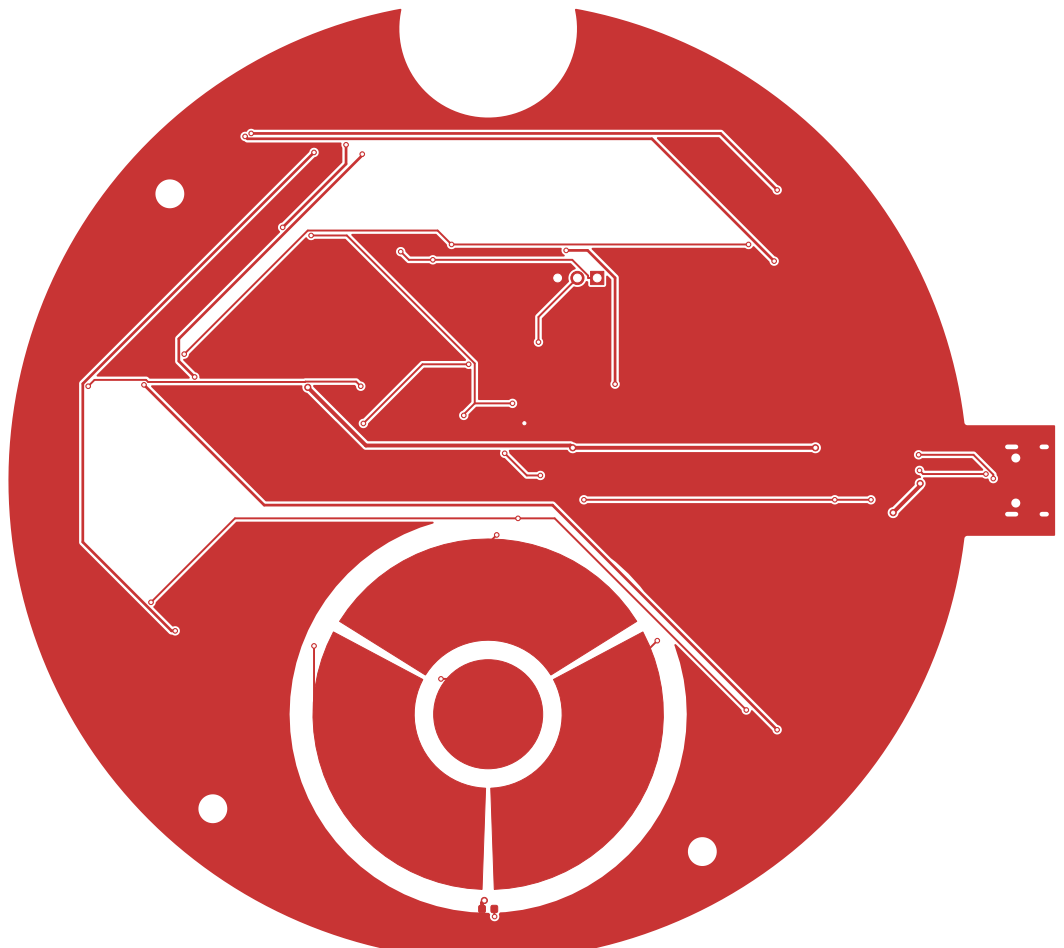
[picture p34: page 1]
