rhetoricguitar3aiEngineer/MotoNode/eclipse-lamp/electronics/core/fab/eclipse-core-layout.pdf/eclipse-core-F_Silkscreen.pdf

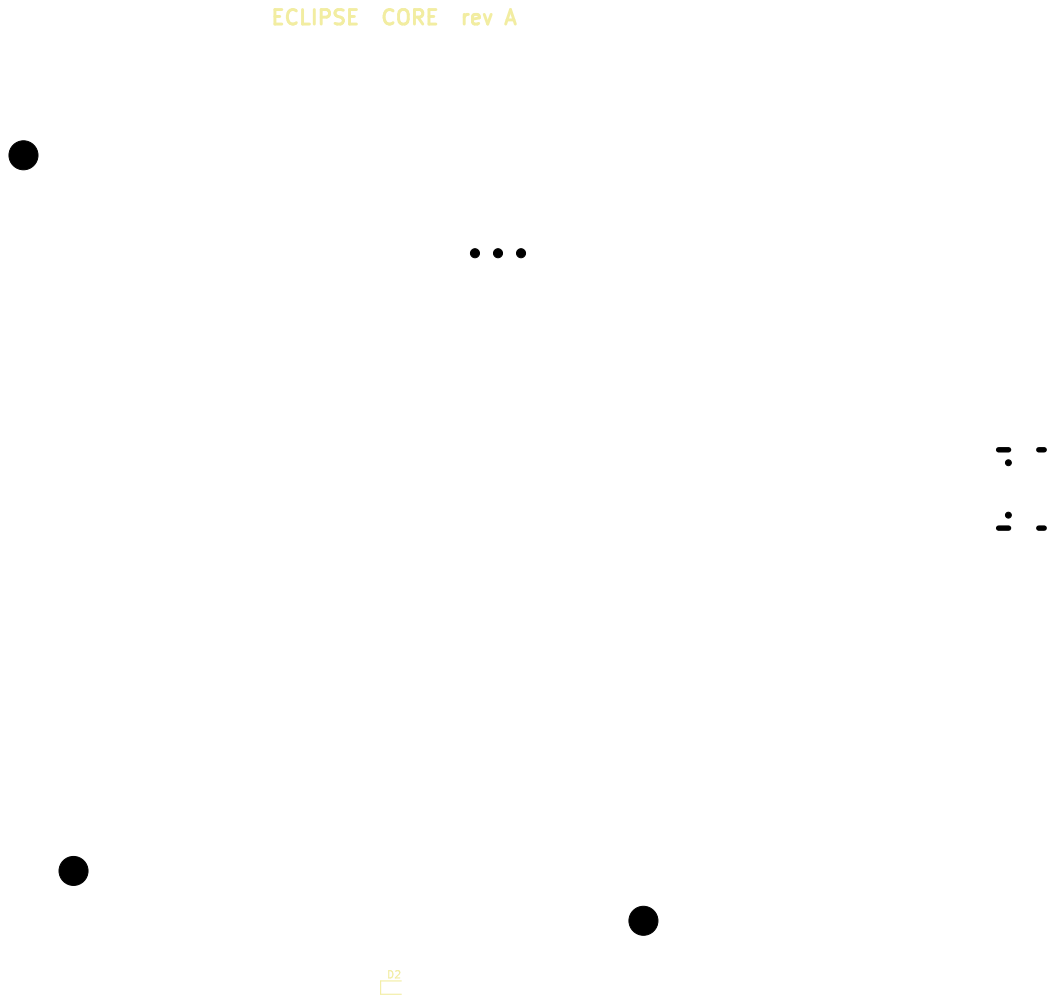
[picture p35: page 1]
