rhetoricguitar3aiEngineer/MotoNode/eclipse-lamp/electronics/hub/fab/eclipse-hub-layout.pdf/eclipse-hub-B_Cu.pdf

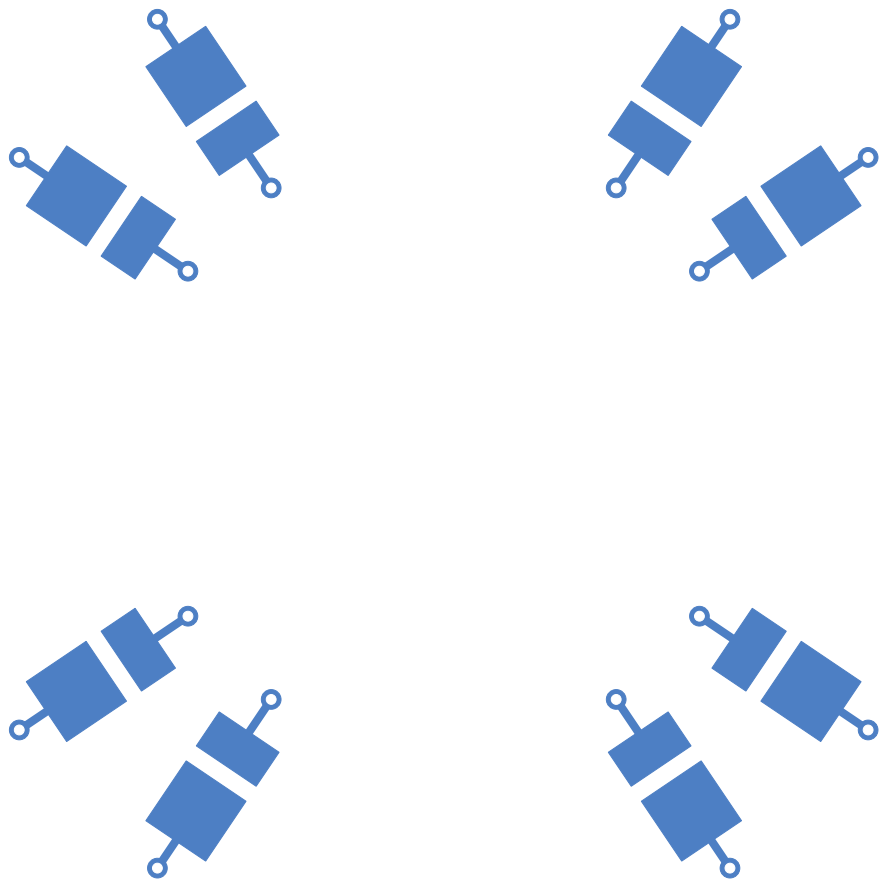
[picture p36: page 1]
