rhetoricguitar3aiEngineer/MotoNode/eclipse-lamp/electronics/hub/fab/eclipse-hub-layout.pdf/eclipse-hub-B_Silkscreen.pdf

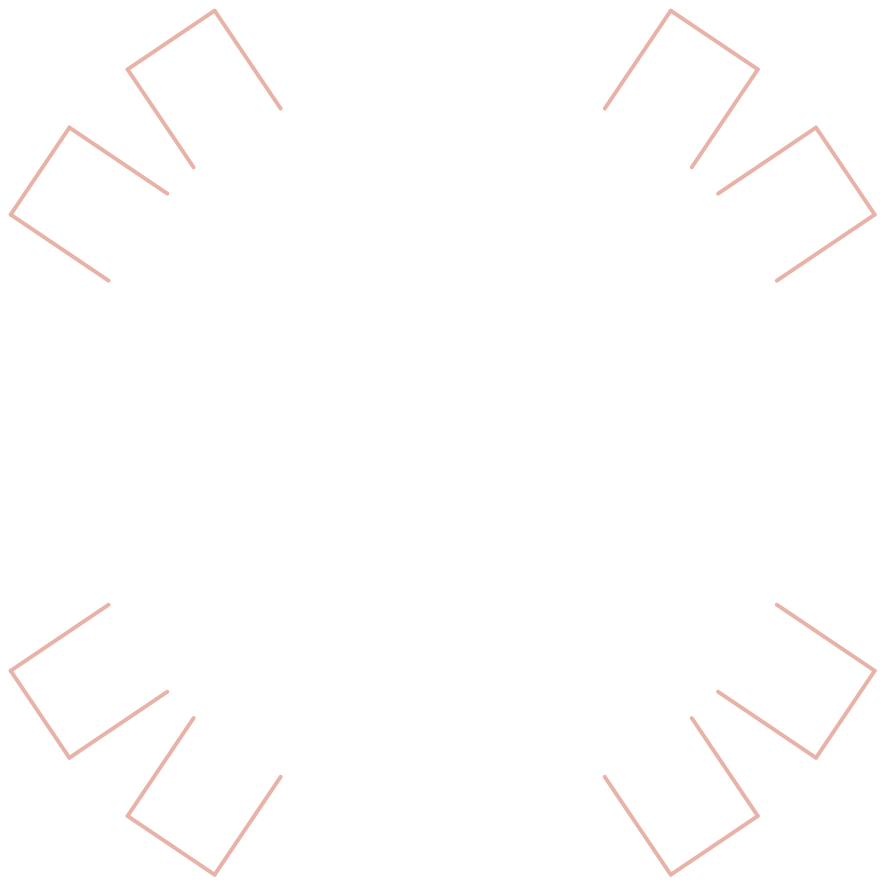
[picture p37: page 1]
