rhetoricguitar3aiEngineer/MotoNode/eclipse-lamp/electronics/hub/fab/eclipse-hub-layout.pdf/eclipse-hub-F_Cu.pdf

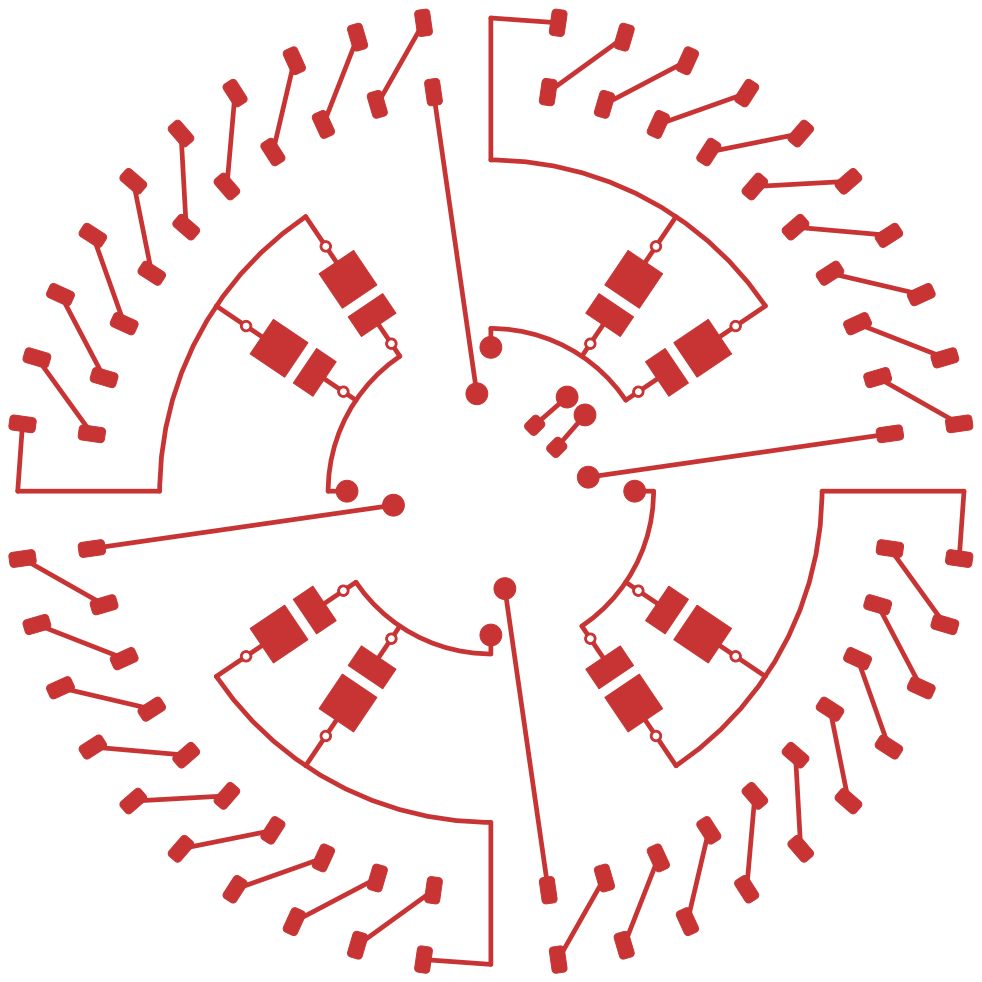
[picture p38: page 1]
