rhetoricguitar3aiEngineer/MotoNode/eclipse-lamp/electronics/hub/fab/eclipse-hub-layout.pdf/eclipse-hub-F_Silkscreen.pdf

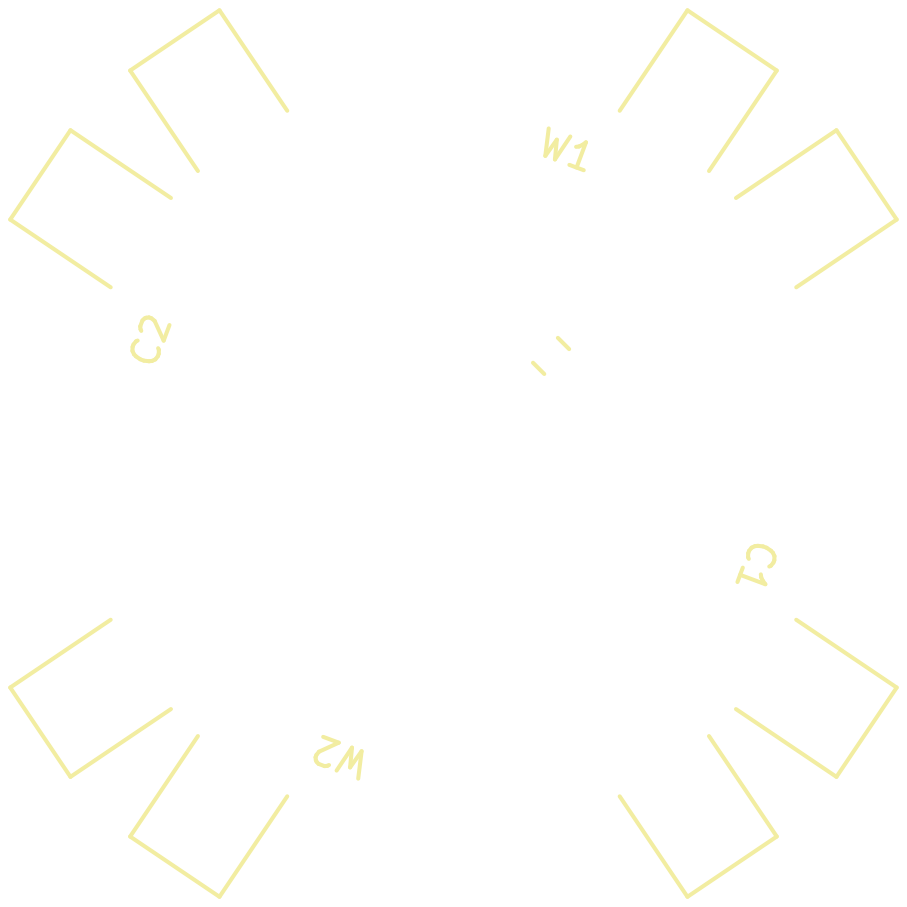
[picture p39: page 1]
