rhetoricguitar3aiEngineer/MotoNode/eclipse-lamp/electronics/sprig/fab/eclipse-sprig-layout.pdf/eclipse-sprig-B_Cu.pdf

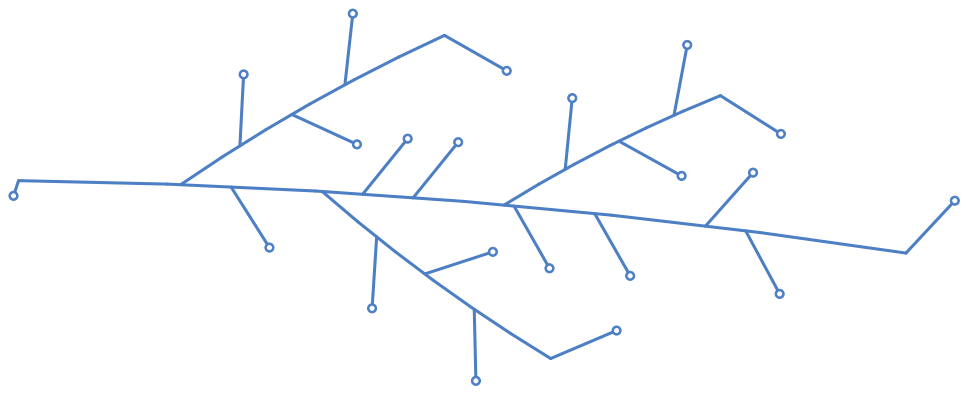
[picture p40: page 1]
