rhetoricguitar3aiEngineer/MotoNode/eclipse-lamp/electronics/sprig/fab/eclipse-sprig-layout.pdf/eclipse-sprig-Edge_Cuts.pdf

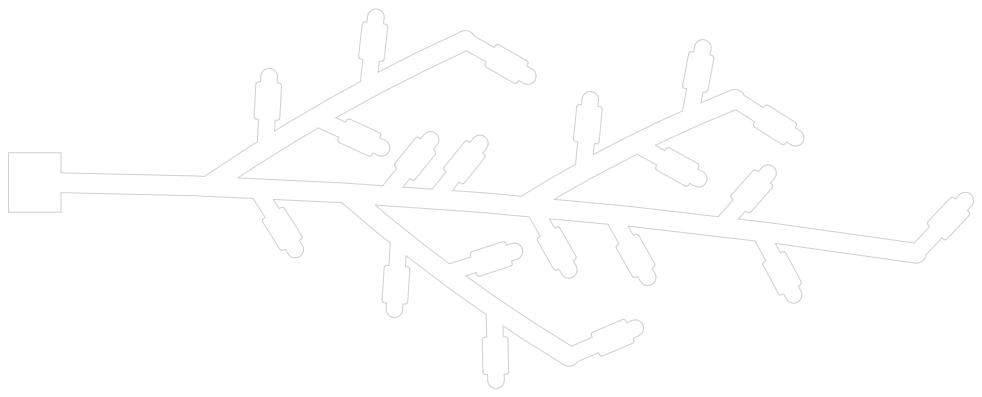
[picture p41: page 1]
