rhetoricguitar3aiEngineer/MotoNode/eclipse-lamp/electronics/sprig/fab/eclipse-sprig-layout.pdf/eclipse-sprig-F_Cu.pdf

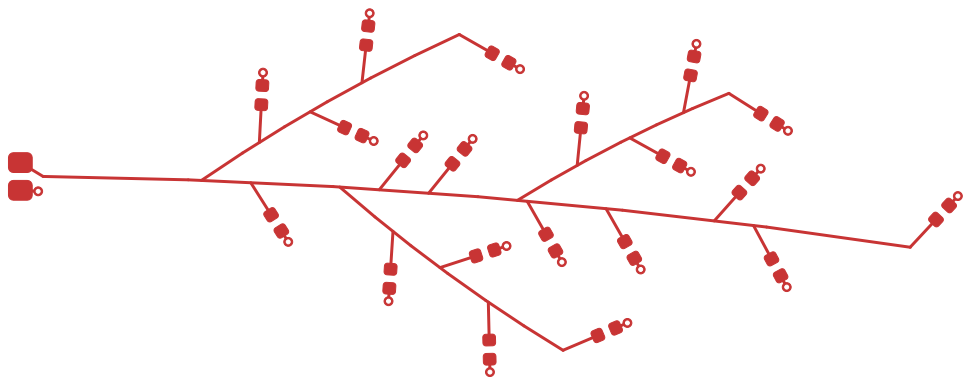
[picture p42: page 1]
