rhetoricguitar3aiEngineer/MotoNode/eclipse-lamp/electronics/sprig/fab/eclipse-sprig-layout.pdf/eclipse-sprig-F_Silkscreen.pdf

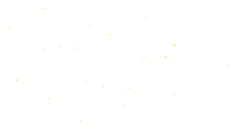
[picture p43: page 1]
