rhetoricguitar3aiEngineer/MotoNode/eclipse-lamp/electronics/hub/eclipse-hub.kicad_pcb

## KiCad design eclipse-lamp/electronics/hub/eclipse-hub.kicad_pcb (2026-10-11)

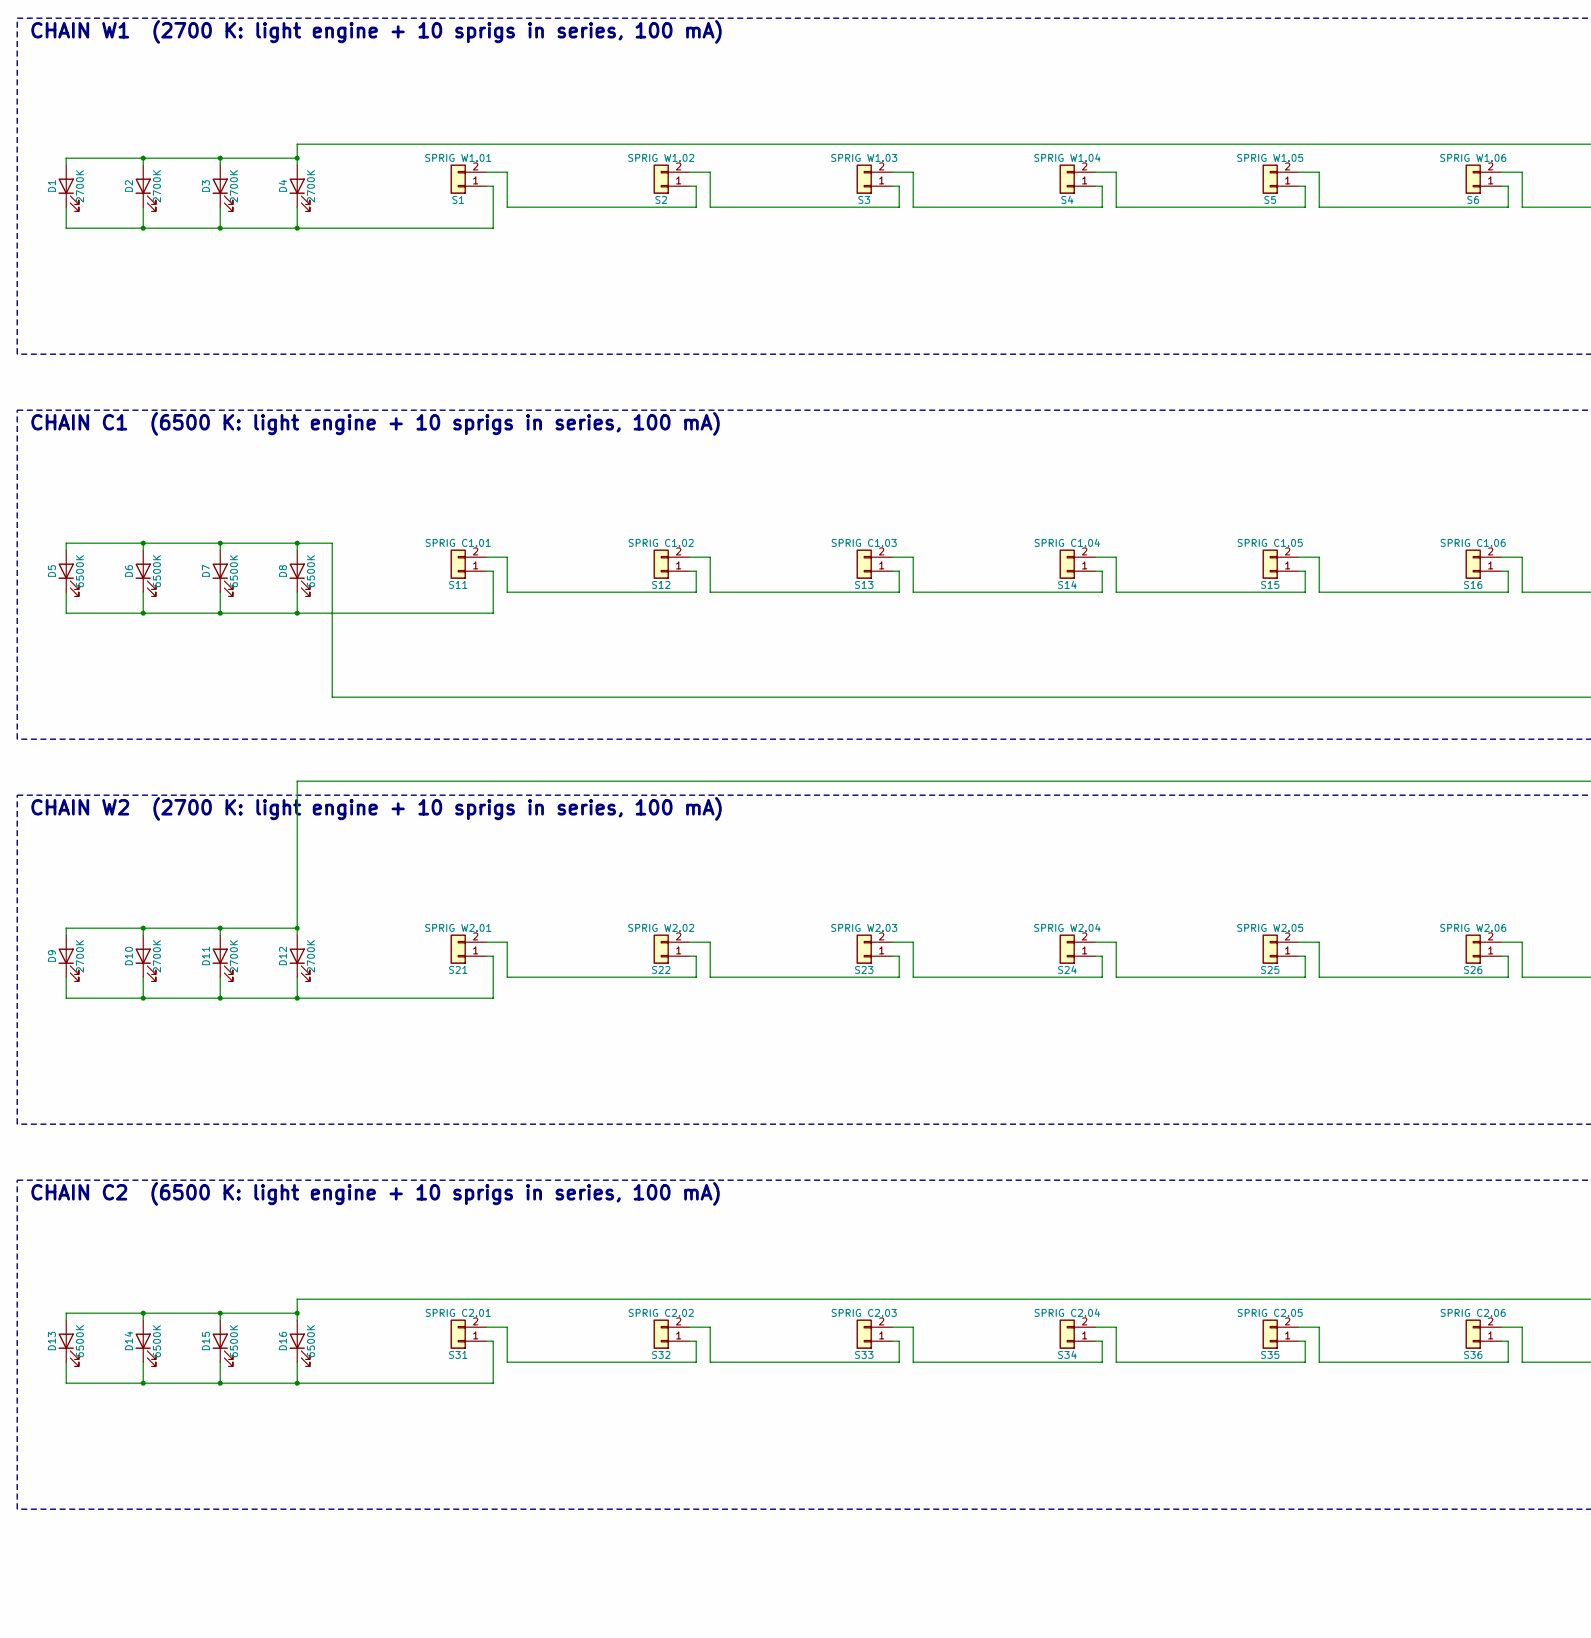
[picture p44: schematic eclipse-hub.kicad_sch, ECLIPSE Tree - Hub light engine (in the burl), part in row 1, column 1]

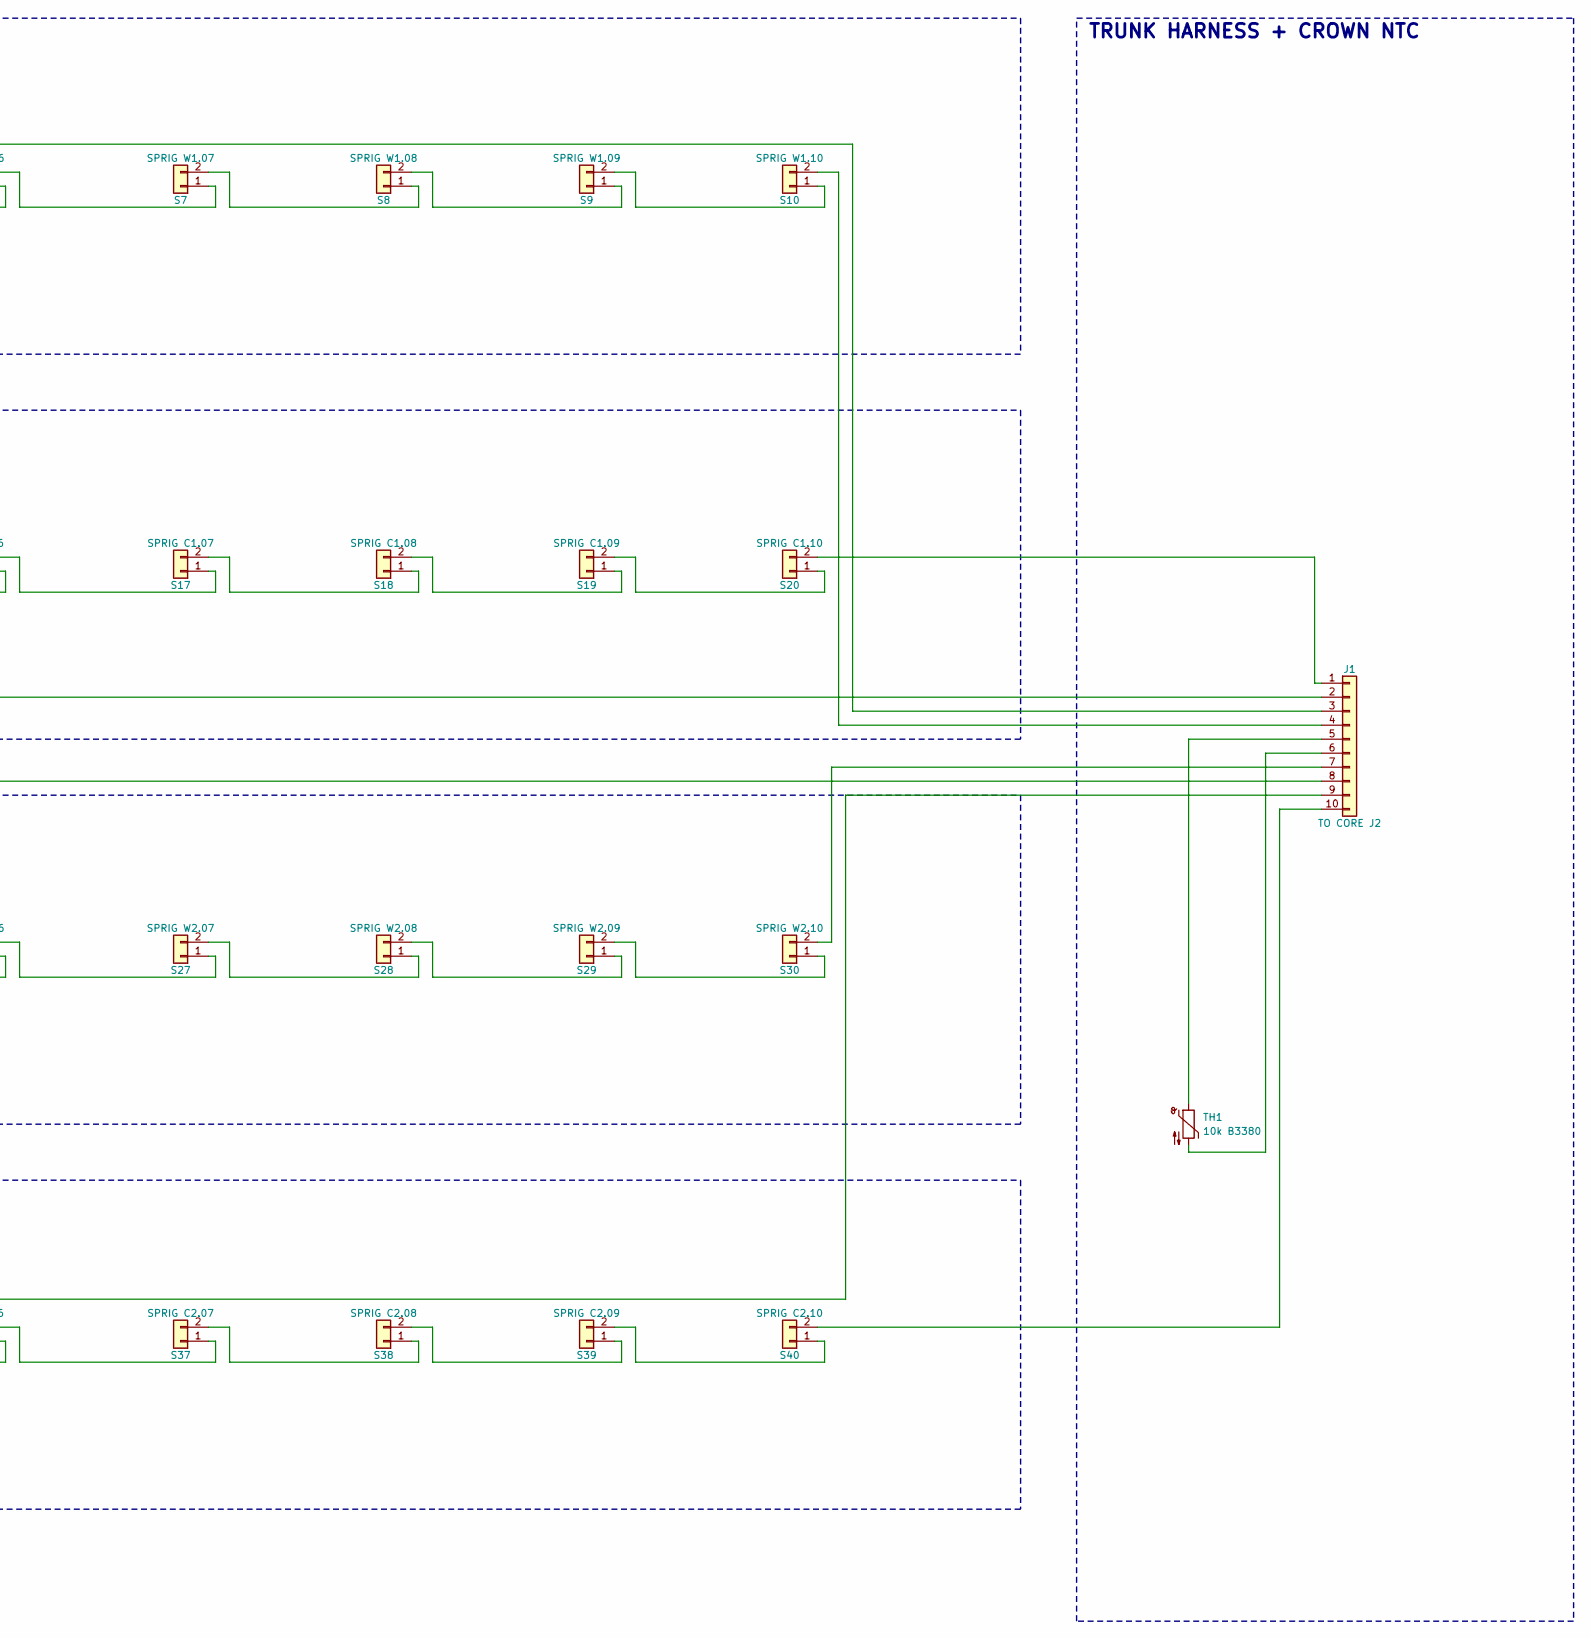
[picture p45: schematic eclipse-hub.kicad_sch, ECLIPSE Tree - Hub light engine (in the burl), part in row 1, column 2]

Parts:
D1, D2, D3, D4, D9, D10, D11, D12: 2700K; LED_PLCC_2835; MPN LM281B+ 2700K
D5, D6, D7, D8, D13, D14, D15, D16: 6500K; LED_PLCC_2835; MPN LM281B+ 6500K
J1: TO CORE J2; HubTrunkPads; MPN wire lands
S1: SPRIG W1.01; HubSprigPads; MPN wire lands
S2: SPRIG W1.02; HubSprigPads; MPN wire lands
S3: SPRIG W1.03; HubSprigPads; MPN wire lands
S4: SPRIG W1.04; HubSprigPads; MPN wire lands
S5: SPRIG W1.05; HubSprigPads; MPN wire lands
S6: SPRIG W1.06; HubSprigPads; MPN wire lands
S7: SPRIG W1.07; HubSprigPads; MPN wire lands
S8: SPRIG W1.08; HubSprigPads; MPN wire lands
S9: SPRIG W1.09; HubSprigPads; MPN wire lands
S10: SPRIG W1.10; HubSprigPads; MPN wire lands
S11: SPRIG C1.01; HubSprigPads; MPN wire lands
S12: SPRIG C1.02; HubSprigPads; MPN wire lands
S13: SPRIG C1.03; HubSprigPads; MPN wire lands
S14: SPRIG C1.04; HubSprigPads; MPN wire lands
S15: SPRIG C1.05; HubSprigPads; MPN wire lands
S16: SPRIG C1.06; HubSprigPads; MPN wire lands
S17: SPRIG C1.07; HubSprigPads; MPN wire lands
S18: SPRIG C1.08; HubSprigPads; MPN wire lands
S19: SPRIG C1.09; HubSprigPads; MPN wire lands
S20: SPRIG C1.10; HubSprigPads; MPN wire lands
S21: SPRIG W2.01; HubSprigPads; MPN wire lands
S22: SPRIG W2.02; HubSprigPads; MPN wire lands
S23: SPRIG W2.03; HubSprigPads; MPN wire lands
S24: SPRIG W2.04; HubSprigPads; MPN wire lands
S25: SPRIG W2.05; HubSprigPads; MPN wire lands
S26: SPRIG W2.06; HubSprigPads; MPN wire lands
S27: SPRIG W2.07; HubSprigPads; MPN wire lands
S28: SPRIG W2.08; HubSprigPads; MPN wire lands
S29: SPRIG W2.09; HubSprigPads; MPN wire lands
S30: SPRIG W2.10; HubSprigPads; MPN wire lands
S31: SPRIG C2.01; HubSprigPads; MPN wire lands
S32: SPRIG C2.02; HubSprigPads; MPN wire lands
S33: SPRIG C2.03; HubSprigPads; MPN wire lands
S34: SPRIG C2.04; HubSprigPads; MPN wire lands
S35: SPRIG C2.05; HubSprigPads; MPN wire lands
S36: SPRIG C2.06; HubSprigPads; MPN wire lands
S37: SPRIG C2.07; HubSprigPads; MPN wire lands
S38: SPRIG C2.08; HubSprigPads; MPN wire lands
S39: SPRIG C2.09; HubSprigPads; MPN wire lands
S40: SPRIG C2.10; HubSprigPads; MPN wire lands
TH1: 10k B3380; R_0603_1608Metric; MPN NCP18XH103F03RB

Connections:
unnamed: D1.2 (A), D2.2 (A), D3.2 (A), D4.2 (A), J1.3
unnamed: D1.1 (K), D2.1 (K), D3.1 (K), D4.1 (K), S1.1
unnamed: D5.2 (A), D6.2 (A), D7.2 (A), D8.2 (A), J1.2
unnamed: D5.1 (K), D6.1 (K), D7.1 (K), D8.1 (K), S11.1
unnamed: D9.2 (A), D10.2 (A), D11.2 (A), D12.2 (A), J1.8
unnamed: D9.1 (K), D10.1 (K), D11.1 (K), D12.1 (K), S21.1
unnamed: D13.2 (A), D14.2 (A), D15.2 (A), D16.2 (A), J1.9
unnamed: D13.1 (K), D14.1 (K), D15.1 (K), D16.1 (K), S31.1
unnamed: J1.1, S20.2
unnamed: J1.4, S10.2
unnamed: J1.5, TH1.1
unnamed: J1.6, TH1.2
unnamed: J1.7, S30.2
unnamed: J1.10, S40.2
unnamed: S1.2, S2.1
unnamed: S2.2, S3.1
unnamed: S3.2, S4.1
unnamed: S4.2, S5.1
unnamed: S5.2, S6.1
unnamed: S6.2, S7.1
unnamed: S7.2, S8.1
unnamed: S8.2, S9.1
unnamed: S9.2, S10.1
unnamed: S11.2, S12.1
unnamed: S12.2, S13.1
unnamed: S13.2, S14.1
unnamed: S14.2, S15.1
unnamed: S15.2, S16.1
unnamed: S16.2, S17.1
unnamed: S17.2, S18.1
unnamed: S18.2, S19.1
unnamed: S19.2, S20.1
unnamed: S21.2, S22.1
unnamed: S22.2, S23.1
unnamed: S23.2, S24.1
unnamed: S24.2, S25.1
unnamed: S25.2, S26.1
unnamed: S26.2, S27.1
unnamed: S27.2, S28.1
unnamed: S28.2, S29.1
unnamed: S29.2, S30.1
unnamed: S31.2, S32.1
unnamed: S32.2, S33.1
unnamed: S33.2, S34.1
unnamed: S34.2, S35.1
unnamed: S35.2, S36.1
unnamed: S36.2, S37.1
unnamed: S37.2, S38.1
unnamed: S38.2, S39.1
unnamed: S39.2, S40.1

Notes on the sheet:
CHAIN W1 (2700 K: light engine + 10 sprigs in series, 100 mA)
CHAIN C1 (6500 K: light engine + 10 sprigs in series, 100 mA)
CHAIN W2 (2700 K: light engine + 10 sprigs in series, 100 mA)
CHAIN C2 (6500 K: light engine + 10 sprigs in series, 100 mA)
TRUNK HARNESS + CROWN NTC

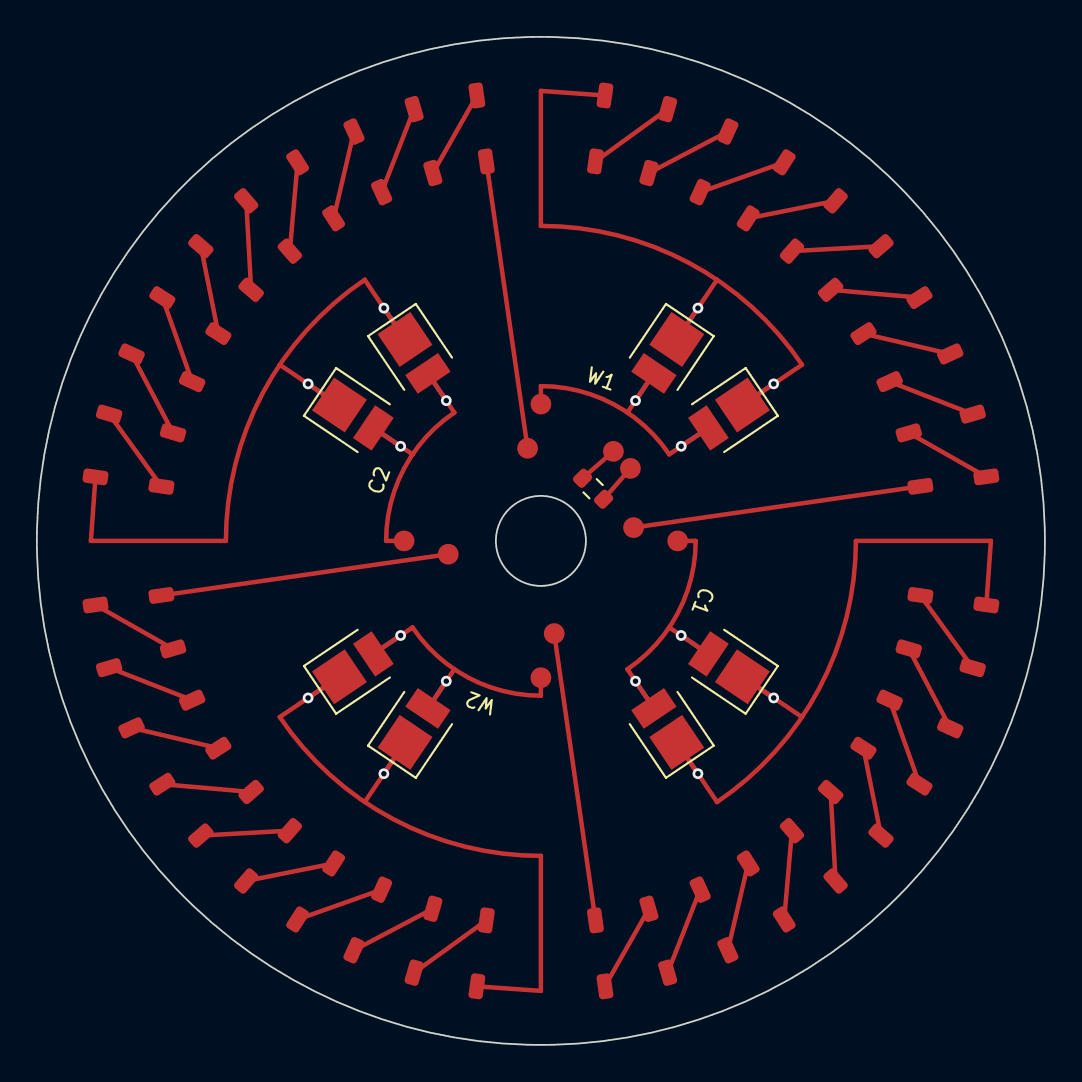
[picture p46: board eclipse-hub.kicad_pcb from above]

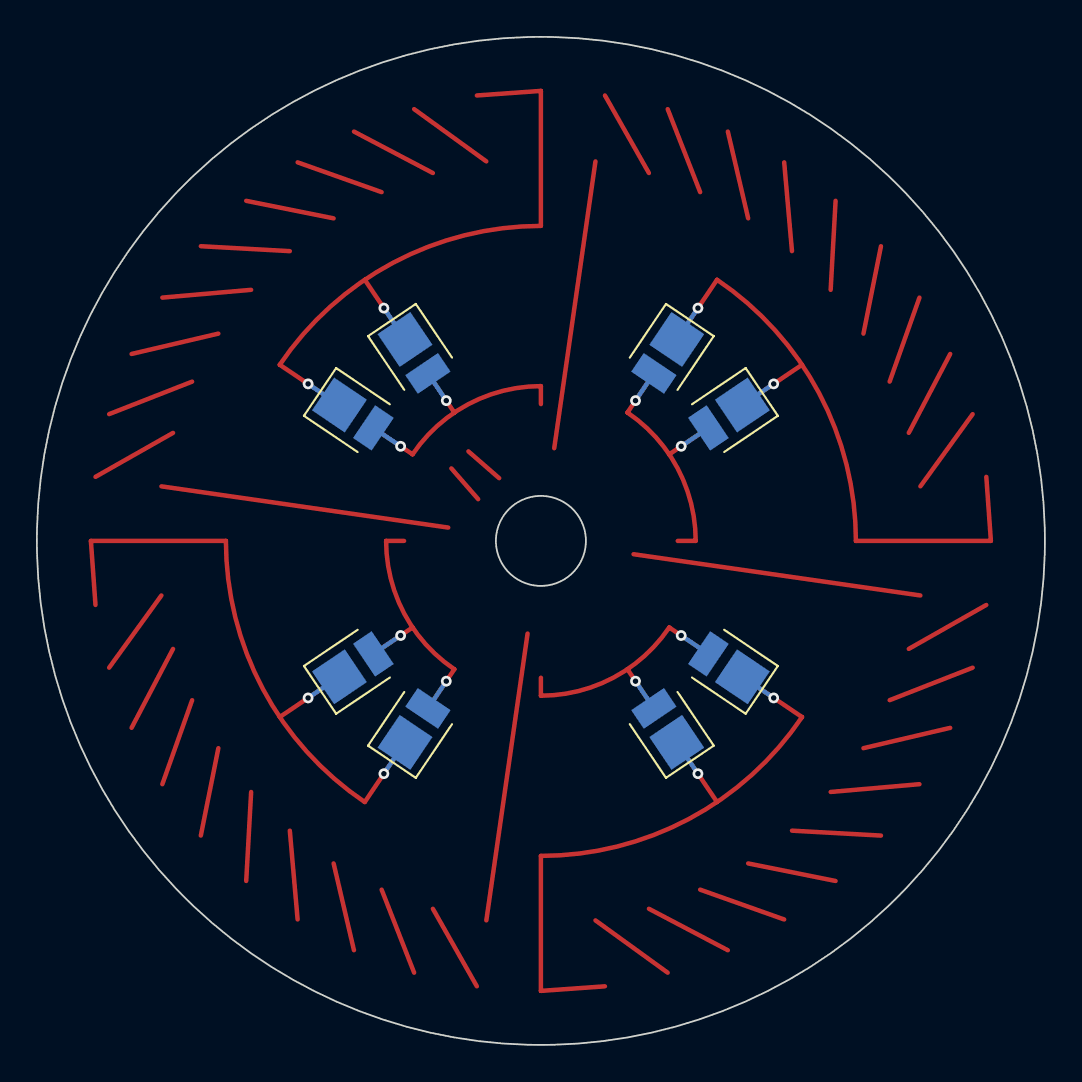
[picture p47: board eclipse-hub.kicad_pcb from below]

Board: 2 copper layers, 56.0 x 56.0 mm, 58 parts (8 on the bottom side), 50 nets.
