rhetoricguitar3aiEngineer/MotoNode/eclipse-lamp/electronics/core/eclipse-core.kicad_pcb

## KiCad design eclipse-lamp/electronics/core/eclipse-core.kicad_pcb (2026-10-11)

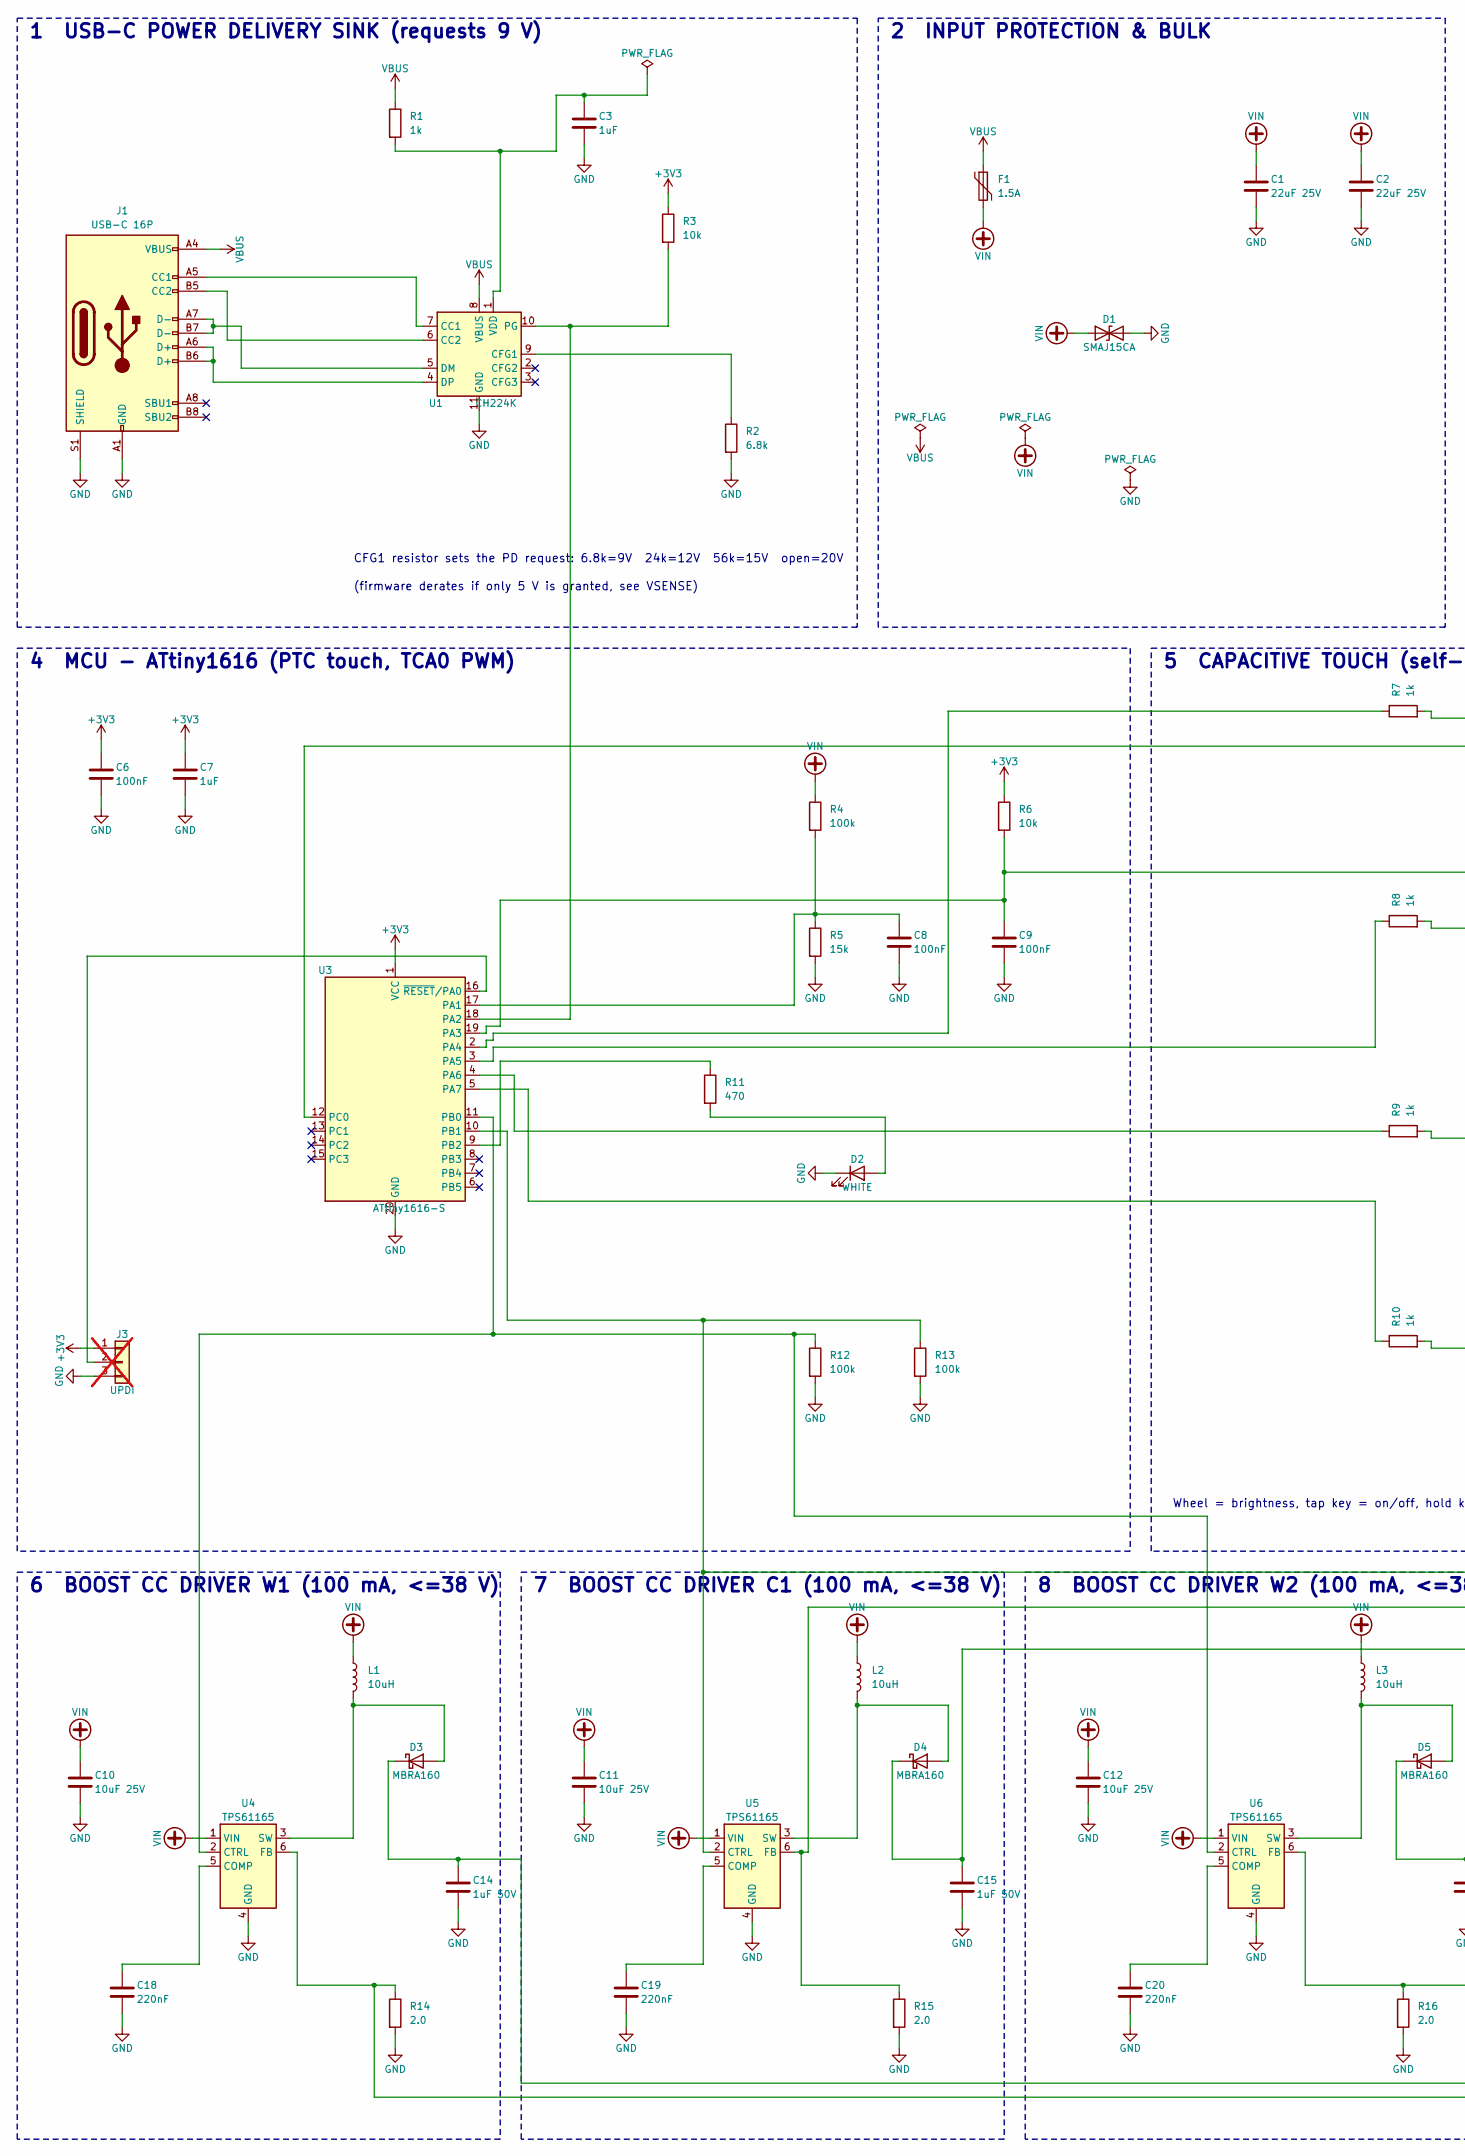
[picture p48: schematic eclipse-core.kicad_sch, ECLIPSE Tree - Core board (base): power, drivers, touch MCU, part in row 1, column 1]

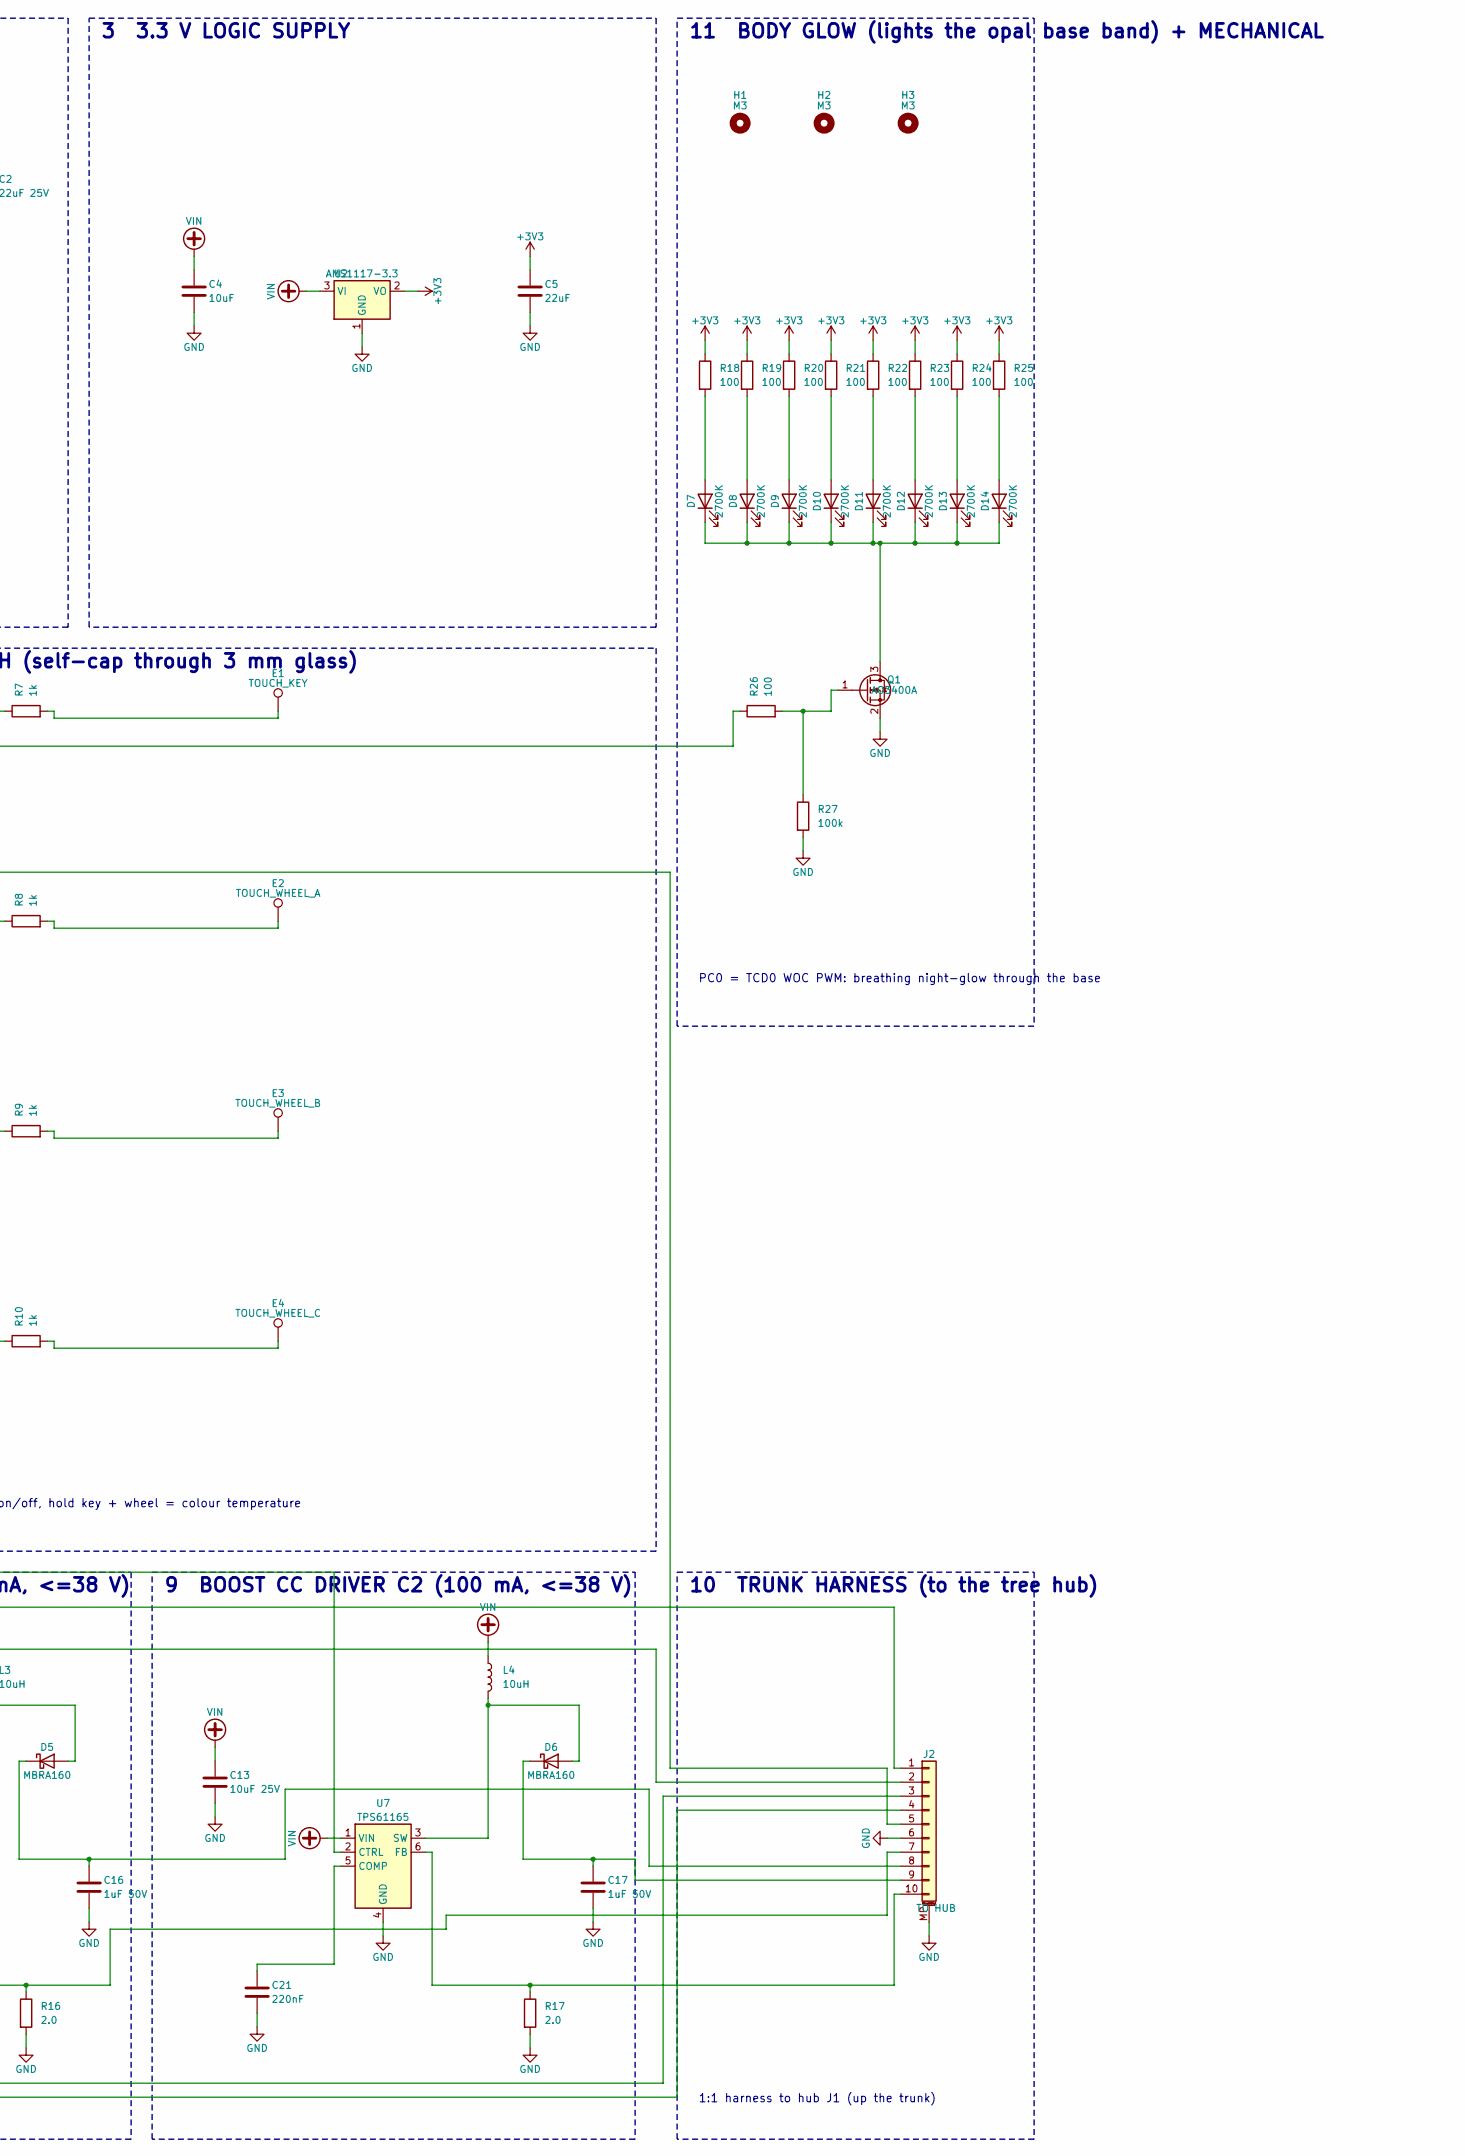
[picture p49: schematic eclipse-core.kicad_sch, ECLIPSE Tree - Core board (base): power, drivers, touch MCU, part in row 1, column 2]

Parts:
C1, C2: 22uF 25V; C_1206_3216Metric; MPN GRM31CR61E226KE15L
C3, C7: 1uF; C_0603_1608Metric; MPN GRM188R61E105KA12D
C4: 10uF; C_0805_2012Metric; MPN CL21A106KAYNNNE
C5: 22uF; C_0805_2012Metric; MPN CL21A226MAQNNNE
C6, C8, C9: 100nF; C_0603_1608Metric; MPN GRM188R71H104KA93D
C10, C11, C12, C13: 10uF 25V; C_0805_2012Metric; MPN CL21A106KAYNNNE
C14, C15, C16, C17: 1uF 50V; C_1206_3216Metric; MPN GRM31MR71H105KA88L
C18, C19, C20, C21: 220nF; C_0603_1608Metric; MPN GRM188R71E224KA88D
D1: SMAJ15CA; D_SMA; MPN SMAJ15CA
D2: WHITE; LED_0603_1608Metric; MPN LTW-C191TS5
D3, D4, D5, D6: MBRA160; D_SMA; MPN MBRA160T3G
D7, D8, D9, D10, D11, D12, D13, D14: 2700K; LED_PLCC_2835; MPN LM281B+ 2700K
E1: TOUCH_KEY; TouchKey_D14; MPN PCB copper electrode
E2: TOUCH_WHEEL_A; TouchWheel_Seg120; MPN PCB copper electrode
E3: TOUCH_WHEEL_B; TouchWheel_Seg120; MPN PCB copper electrode
E4: TOUCH_WHEEL_C; TouchWheel_Seg120; MPN PCB copper electrode
F1: 1.5A; Fuse_1812_4532Metric; MPN MF-MSMF150/24X-2
H1, H2, H3: M3; MountingHole_3.2mm_M3
J1: USB-C 16P; USB_C_Receptacle_HRO_TYPE-C-31-M-12; MPN TYPE-C-31-M-12; LCSC C165948
J2: TO HUB; JST_PH_S10B-PH-SM4-TB_1x10-1MP_P2.00mm_Horizontal; MPN S10B-PH-SM4-TB
J3: UPDI; PinHeader_1x03_P2.54mm_Vertical; MPN DNP (pogo pads); not fitted
L1, L2, L3, L4: 10uH; L_Bourns-SRN4018; MPN SRN4018-100M
Q1: AO3400A; SOT-23; MPN AO3400A
R1, R7, R8, R9, R10: 1k; R_0603_1608Metric; MPN RC0603FR-071KL
R2: 6.8k; R_0603_1608Metric; MPN RC0603FR-076K8L
R3, R6: 10k; R_0603_1608Metric; MPN RC0603FR-0710KL
R4, R12, R13, R27: 100k; R_0603_1608Metric; MPN RC0603FR-07100KL
R5: 15k; R_0603_1608Metric; MPN RC0603FR-0715KL
R11: 470; R_0603_1608Metric; MPN RC0603FR-07470RL
R14, R15, R16, R17: 2.0; R_0805_2012Metric; MPN RC0805FR-072RL
R18, R19, R20, R21, R22, R23, R24, R25, R26: 100; R_0603_1608Metric; MPN RC0603FR-07100RL
U1: CH224K; SSOP-10-1EP_3.9x4.9mm_P1mm_EP2.1x3.3mm; MPN CH224K; LCSC C970725
U2: AMS1117-3.3; SOT-223-3_TabPin2; MPN AMS1117-3.3; LCSC C6186
U3: ATtiny1616-S; SOIC-20W_7.5x12.8mm_P1.27mm; MPN ATTINY1616-SNR
U4, U5, U6, U7: TPS61165; SOT-23-6; MPN TPS61165DBVR

Connections:
+3V3: C5.1, C6.1, C7.1, J3.1, R3.1, R6.1, R18.1, R19.1, R20.1, R21.1, R22.1, R23.1, R24.1, R25.1, U2.2 (VO), U3.1 (VCC)
GND: C1.2, C2.2, C3.2, C4.2, C5.2, C6.2, C7.2, C8.2, C9.2, C10.2, C11.2, C12.2, C13.2, C14.2, C15.2, C16.2, C17.2, C18.2, C19.2, C20.2, C21.2, D1.2 (A2), D2.1 (K), J1.A1 (GND), J1.A12 (GND), J1.B1 (GND), J1.B12 (GND), J1.S1 (SHIELD), J2.6, J2.MP (MountPin), J3.3, Q1.2 (S), R2.2, R5.2, R12.2, R13.2, R14.2, R15.2, R16.2, R17.2, R27.2, U1.11 (GND), U2.1 (GND), U3.20 (GND), U4.4 (GND), U5.4 (GND), U6.4 (GND), U7.4 (GND)
unnamed: D2.2 (A), R11.2
unnamed: D3.2 (A), L1.2, U4.3 (SW)
unnamed: C14.1, D3.1 (K), J2.3
unnamed: D4.2 (A), L2.2, U5.3 (SW)
unnamed: C15.1, D4.1 (K), J2.2
unnamed: D5.2 (A), L3.2, U6.3 (SW)
unnamed: C16.1, D5.1 (K), J2.8
unnamed: D6.2 (A), L4.2, U7.3 (SW)
unnamed: C17.1, D6.1 (K), J2.9
unnamed: D7.2 (A), R18.2
unnamed: D8.2 (A), R19.2
unnamed: D9.2 (A), R20.2
unnamed: D10.2 (A), R21.2
unnamed: D7.1 (K), D8.1 (K), D9.1 (K), D10.1 (K), D11.1 (K), D12.1 (K), D13.1 (K), D14.1 (K), Q1.3 (D)
unnamed: D11.2 (A), R22.2
unnamed: D12.2 (A), R23.2
unnamed: D13.2 (A), R24.2
unnamed: D14.2 (A), R25.2
unnamed: E1.1, R7.2
unnamed: E2.1, R8.2
unnamed: E3.1, R9.2
unnamed: E4.1, R10.2
unnamed: J1.A5 (CC1), U1.7 (CC1)
unnamed: J1.B5 (CC2), U1.6 (CC2)
unnamed: J2.1, R15.1, U5.6 (FB)
unnamed: J2.4, R14.1, U4.6 (FB)
unnamed: C9.1, J2.5, R6.2, U3.19 (PA3)
unnamed: J2.7, R16.1, U6.6 (FB)
unnamed: J2.10, R17.1, U7.6 (FB)
unnamed: J3.2, U3.16 (~RESET/PA0)
unnamed: Q1.1 (G), R26.2, R27.1
unnamed: R2.1, U1.9 (CFG1)
unnamed: J1.A7 (D-), J1.B7 (D-), U1.5 (DM)
unnamed: J1.A6 (D+), J1.B6 (D+), U1.4 (DP)
unnamed: R3.2, U1.10 (PG), U3.18 (PA2)
unnamed: C3.1, R1.2, U1.1 (VDD)
unnamed: C8.1, R4.2, R5.1, U3.17 (PA1)
unnamed: R7.1, U3.2 (PA4)
unnamed: R8.1, U3.3 (PA5)
unnamed: R9.1, U3.4 (PA6)
unnamed: R10.1, U3.5 (PA7)
unnamed: R12.1, U3.11 (PB0), U4.2 (CTRL), U6.2 (CTRL)
unnamed: R13.1, U3.10 (PB1), U5.2 (CTRL), U7.2 (CTRL)
unnamed: R11.1, U3.9 (PB2)
unnamed: R26.1, U3.12 (PC0)
unnamed: C18.1, U4.5 (COMP)
unnamed: C19.1, U5.5 (COMP)
unnamed: C20.1, U6.5 (COMP)
unnamed: C21.1, U7.5 (COMP)
VBUS: F1.1, J1.A4 (VBUS), J1.A9 (VBUS), J1.B4 (VBUS), J1.B9 (VBUS), R1.1, U1.8 (VBUS)
VIN: C1.1, C2.1, C4.1, C10.1, C11.1, C12.1, C13.1, D1.1 (A1), F1.2, L1.1, L2.1, L3.1, L4.1, R4.1, U2.3 (VI), U4.1 (VIN), U5.1 (VIN), U6.1 (VIN), U7.1 (VIN)

Notes on the sheet:
1 USB-C POWER DELIVERY SINK (requests 9 V)
CFG1 resistor sets the PD request: 6.8k=9V 24k=12V 56k=15V open=20V
(firmware derates if only 5 V is granted, see VSENSE)
2 INPUT PROTECTION & BULK
3 3.3 V LOGIC SUPPLY
4 MCU - ATtiny1616 (PTC touch, TCA0 PWM)
5 CAPACITIVE TOUCH (self-cap through 3 mm glass)
Wheel = brightness, tap key = on/off, hold key + wheel = colour temperature
6 BOOST CC DRIVER W1 (100 mA, <=38 V)
7 BOOST CC DRIVER C1 (100 mA, <=38 V)
8 BOOST CC DRIVER W2 (100 mA, <=38 V)
9 BOOST CC DRIVER C2 (100 mA, <=38 V)
11 BODY GLOW (lights the opal base band) + MECHANICAL
PC0 = TCD0 WOC PWM: breathing night-glow through the base
10 TRUNK HARNESS (to the tree hub)
1:1 harness to hub J1 (up the trunk)

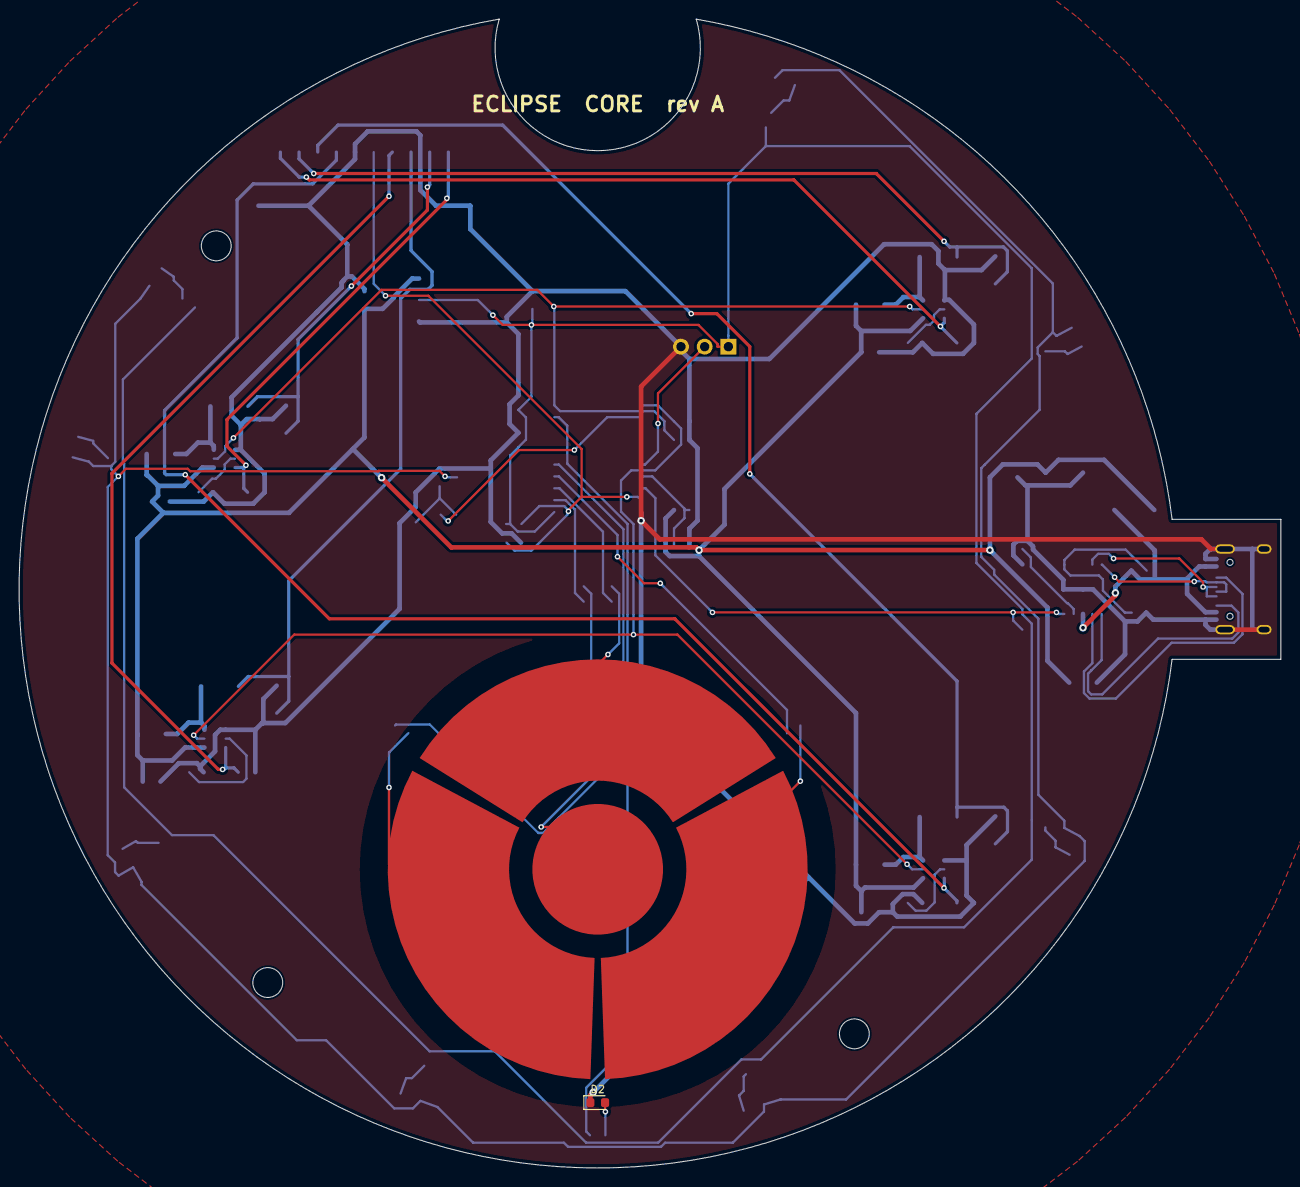
[picture p50: board eclipse-core.kicad_pcb from above]

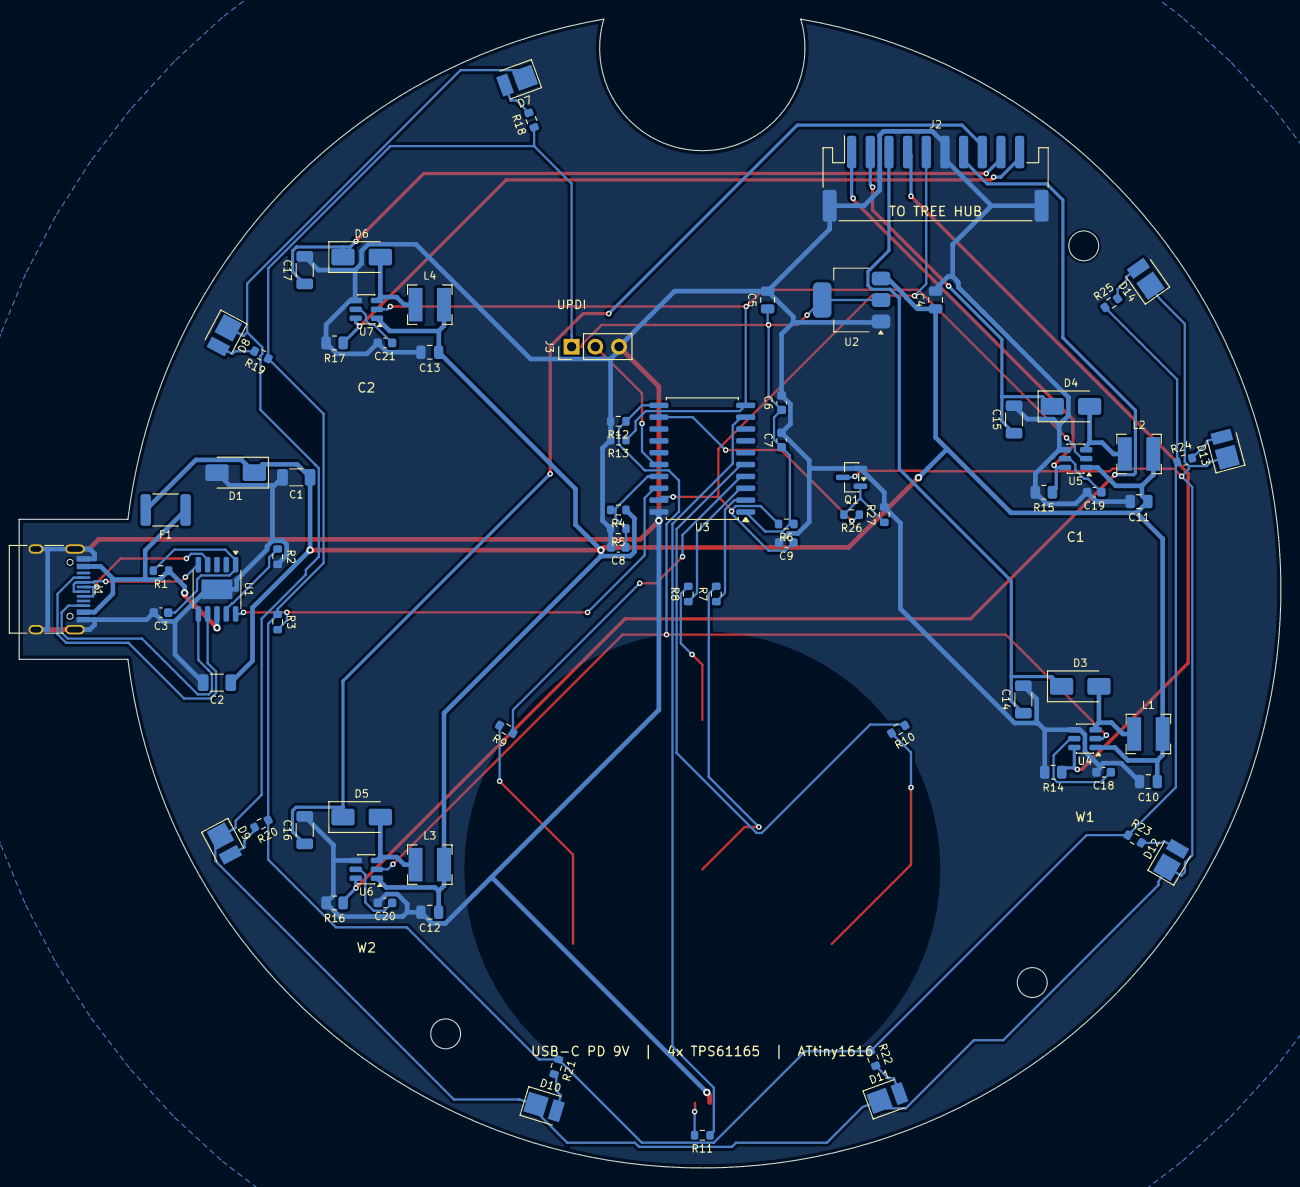
[picture p51: board eclipse-core.kicad_pcb from below]

Board: 2 copper layers, 135.2 x 123.1 mm, 85 parts (80 on the bottom side), 53 nets.
