rhetoricguitar3aiEngineer/MotoNode/eclipse-lamp/electronics/sprig/eclipse-sprig.kicad_pcb

## KiCad design eclipse-lamp/electronics/sprig/eclipse-sprig.kicad_pcb (2026-10-10)

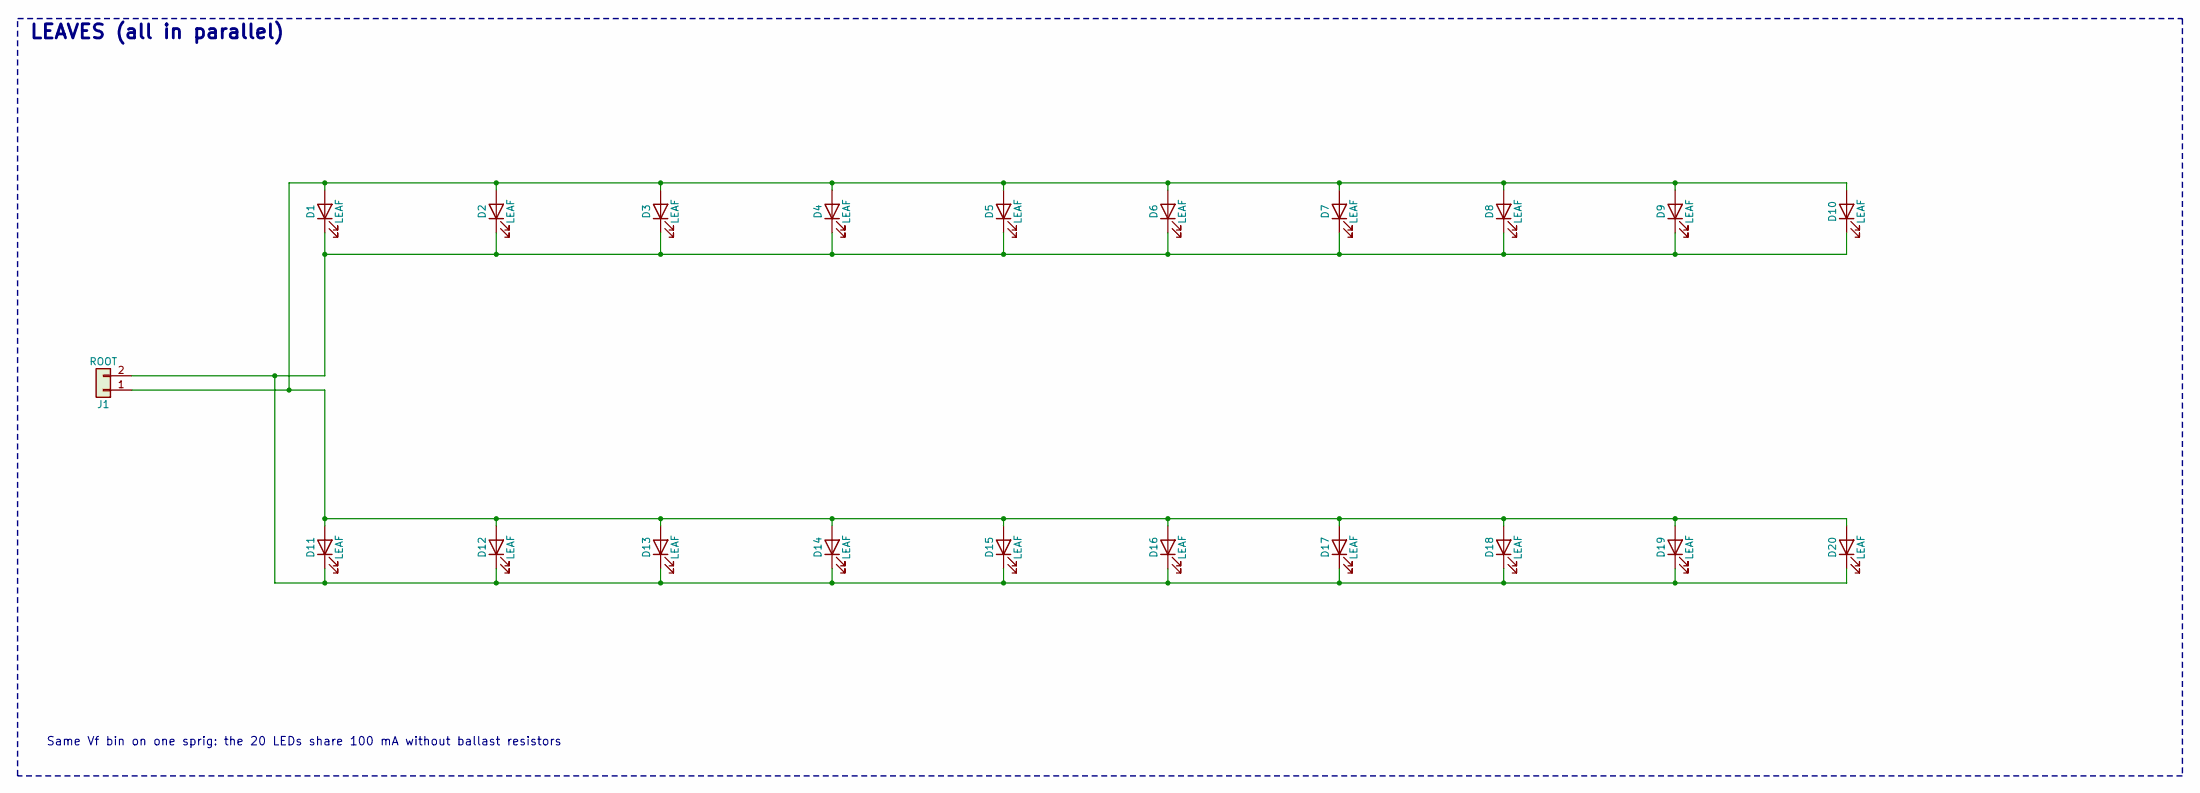
[picture p52: schematic eclipse-sprig.kicad_sch, ECLIPSE Tree - LED sprig flex (20 leaves)]

Parts:
D1, D2, D3, D4, D5, D6, D7, D8, D9, D10, D11, D12, D13, D14, D15, D16, D17, D18, D19, D20: LEAF; LED_0402_1005Metric; MPN 0402 white LED, 2700K or 6500K
J1: ROOT; SprigRoot; MPN PCB land

Connections:
unnamed: D1.2 (A), D2.2 (A), D3.2 (A), D4.2 (A), D5.2 (A), D6.2 (A), D7.2 (A), D8.2 (A), D9.2 (A), D10.2 (A), D11.2 (A), D12.2 (A), D13.2 (A), D14.2 (A), D15.2 (A), D16.2 (A), D17.2 (A), D18.2 (A), D19.2 (A), D20.2 (A), J1.1
unnamed: D1.1 (K), D2.1 (K), D3.1 (K), D4.1 (K), D5.1 (K), D6.1 (K), D7.1 (K), D8.1 (K), D9.1 (K), D10.1 (K), D11.1 (K), D12.1 (K), D13.1 (K), D14.1 (K), D15.1 (K), D16.1 (K), D17.1 (K), D18.1 (K), D19.1 (K), D20.1 (K), J1.2

Notes on the sheet:
LEAVES (all in parallel)
Same Vf bin on one sprig: the 20 LEDs share 100 mA without ballast resistors

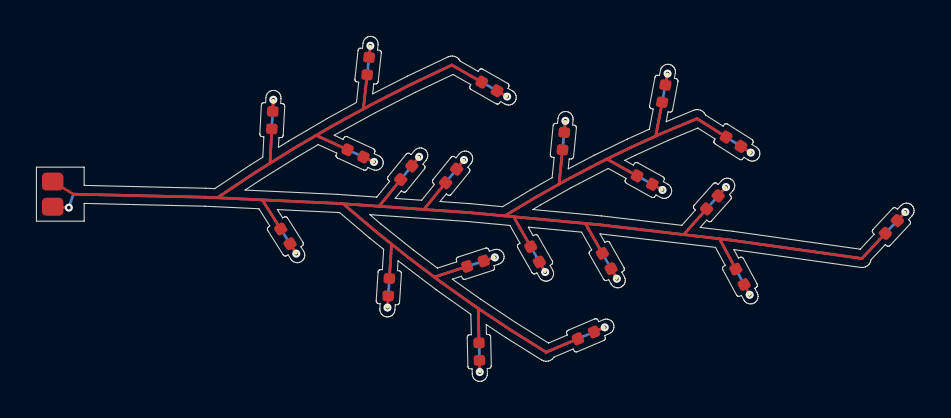
[picture p53: board eclipse-sprig.kicad_pcb from above]

Board: 2 copper layers, 48.8 x 19.2 mm, 21 parts (0 on the bottom side), 2 nets.
