rhetoricguitar3aiEngineer/MotoNode/(commit log)

2026-10-07 Add ECLIPSE halo desk lamp: CAD, KiCad schematics/PCBs, BOM, renders
    - Parametric CadQuery model (STEP/STL per part + assembly)
    - Core board (USB-C PD 9 V, 4x TPS61165 CC boost, ATtiny1616 touch) and
    40-LED halo ring board, both ERC/DRC clean with schematic parity
    - Schematics drawn with visible wires for every signal (power symbols only
    for rails); netlists verified against the design description
    - Fab outputs (gerbers, drill, P&P, PDFs), BOM with cost estimates,
    Blender/Cycles and KiCad 3D renders, design notes
    - CLAUDE.md: permanent rule for wired schematics
    Claude-Session: https://claude.ai/code/session_01UC4Dpjx8nsVkJqTcucsg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
    [base_foot.step, base_foot.stl, base_shell.step, base_shell.stl, base_weight.step, base_weight.stl, bottom_cover.step, bottom_cover.stl]
2026-10-10 ECLIPSE: light emanates through the body (diffusion redesign)
    - Halo is now a hollow light-diffusing PMMA body under a thin graphite cap;
    the LED board fires down into it, so the underside gives task light and
    the walls glow with a soft falloff toward the cap
    - Base gains a glowing opal band lit by an internal light chamber (white
    steel reflector/weight); steel plinth keeps the CoG 40 mm inside the edge
    - Core board: 8 rim 2835 LEDs + AO3400A on PC0 (TCD0 PWM) for the base glow;
    schematic fully wired (no labels), ERC/DRC clean, re-routed, fab re-exported
    - Renders: glow-material shader, new close-up and night-glow shots
    - BOM, README and design notes updated (thermal/PMMA margin, sta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
    [base_band.step, base_band.stl, base_foot.step, base_plinth.step, base_plinth.stl, base_shell.step, base_shell.stl, base_weight.step]
2026-10-10 ECLIPSE Tree: an intricately branched cedar elm whose 800 leaves are 0402 LEDs
    - Procedural cedar-elm generator (seeded): S-curved trunk, burl fork, 4 limbs,
    75 branches + 189 spur twigs, pipe-model diameters, drooping branchlets
    - New sprig flex PCB: 2-layer polyimide cedar-elm spray, 20 x 0402 LED leaves
    in parallel, outline grown around the copper; shared layout with the 3D model
    - New hub PCB (in the burl): 40 sprig lands, four 10-sprig series chains, NTC;
    same 10-wire harness pinout so the core board circuit is unchanged
    - Halo ring board retired; all schematics fully wired, ERC/DRC/parity clean
    - CAD, BOM (~$72), wiring map, README/design notes and Cycles renders updated
    Co-Auth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
    [base_band.step, base_foot.step, base_plinth.step, base_shell.step, base_shell.stl, base_weight.step, branches.stl, burl.step]
2026-10-11 ECLIPSE Tree: thick glowing trunk, 5x crown, fibre-lit samaras, hub light engine
    - Tree: 44 mm cast-bronze trunk shell around a PMMA light-guide core with
    glowing bark fissures, 6 buttress roots, D68 burl, 73 branches + 1222 spur
    twigs, 657 end-glow fibre tips with diffusing samaras
    - Hub: D56 two-sided light engine (8 LEDs into the trunk core, 8 into the
    fibre bundles) as the first series element of each 100 mA chain; core
    board circuit unchanged; ERC/DRC/parity clean, all schematics wired
    - Renders: fissure-glow bark shader, samaras, trunk close-up; BOM, docs
    Claude-Session: https://claude.ai/code/session_01UC4Dpjx8nsVkJqTcuc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
2026-10-16 ECLIPSE Tree: regrow the tree so it reads as a real cedar elm
    Space-colonisation crown in a lobed rounded envelope, pipe-model taper
    from a 77 mm trunk through three leaders to 1,174 twigs, a smooth
    tangent-lobed fork (the ball burl is gone; the hub sits in the fork
    swelling), half-buried buttress roots, 21,770 light-diffusing film leaves,
    smaller samaras, sprigs grafted inside the crown. Renderer blends the
    wood into one remeshed body, adds translucent foliage and bark furrows.
    Docs, BOM, wiring map and hub schematic title updated (ERC/DRC clean).
    Claude-Session: https://claude.ai/code/session_01UC4Dpjx8nsVkJqTcucsgsg
2026-10-16 ECLIPSE Tree: final renders of the regrown cedar elm; light-guide tube stops under the hub
    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
